tocksin/gtxl/resources/Assembly.xlsx

Sheet: Sheet1
 | Inst | Code |  | Mode | Code |  | Databus Source | Code |  | Zero Page Registers |  | Labels
 | ld | 0 |  | [80,D],AC | 0 |  | D | 0 |  | 0 | AC storage | VIDEO_HANDLER |  | 12
 | and | 32 |  | [80,X],AC | 4 |  | MEM | 1 |  | 1 | Y storage | BOOT_VECTOR |  | 46
 | or | 64 |  | [Y,D],AC | 8 |  | AC | 2 |  | 2 | X storage | MAIN_LOOP |  | 52
 | xor | 96 |  | [Y,X],AC | 12 |  | Y | 3 |  | 3 | BOOTCNT
 | add | 128 |  | [80,D],X | 16 |  |  | 0 |  | 4 | TEST COUNT
 | sub | 160 |  | [80,D],Y | 20
 | st | 192 |  | [80,D],VID | 24
 | bcc | 224 |  | [Y,X++],VID | 28
 | jmp | 224 |  |  | 0
 | bgt | 228 |  | AC | 0
 | blt | 232 |  | X | 16
 | bne | 236 |  | Y | 20
 | beq | 240 |  | VID | 24
 | bge | 244 |  | [80,D] | 0
 | ble | 248 |  | [80,X] | 4
 | bra | 252 |  | [Y,D] | 8
 | reti | 227 |  | [Y,X] | 12
 | nop | 2 |  | [Y,X++] | 28
ROM Address |  |  |  | Immediate Data |  | InstCode | ModeCode | DataBusCode | Full Instruction |  | Copy/Paste into VHDL
0 | st | [80,D] | AC | 0 |  | 192 | 0 | 2 | 194 |  |  | 0 | =>x" | C2 | ", | 1 | =>x" | 00 | ", -- | st | [80,D] | AC | -- store AC to 0x8000 | -- save register states
2 | st | [80,D] | Y | 1 |  | 192 | 0 | 3 | 195 |  |  | 2 | =>x" | C3 | ", | 3 | =>x" | 01 | ", -- | st | [80,D] | Y | -- store Y to 0x8001
4 | ld | X | D | 56 |  | 0 | 16 | 0 | 16 |  |  | 4 | =>x" | 10 | ", | 5 | =>x" | 38 | ", -- | ld | X | D | -- Set X to 0x55 | --reload timer
6 | ld | [80,D] | MEM | 3 |  | 0 | 0 | 1 | 1 |  |  | 6 | =>x" | 01 | ", | 7 | =>x" | 03 | ", -- | ld | [80,D] | MEM | -- Load BOOTCNT | --check if booting finished
8 | xor | AC | D | 55 |  | 96 | 0 | 0 | 96 |  |  | 8 | =>x" | 60 | ", | 9 | =>x" | 37 | ", -- | xor | AC | D | --XOR compare 55 with BOOTCNT
10 | bne |  | D | 46 |  | 236 | 0 | 0 | 236 |  |  | 10 | =>x" | EC | ", | 11 | =>x" | 2E | ", -- | bne | 0 | D | -- branch to BOOT_VECTOR if not equal
12 | ld | AC | D | 0 |  | 0 | 0 | 0 | 0 |  |  | 12 | =>x" | 00 | ", | 13 | =>x" | 00 | ", -- | ld | AC | D | -- clear registers | -- VIDEO_HANDLER
14 | ld | y | D | 0 |  | 0 | 20 | 0 | 20 |  |  | 14 | =>x" | 14 | ", | 15 | =>x" | 00 | ", -- | ld | y | D
16 | ld | [80,D],AC | MEM | 0 |  | 0 | 0 | 1 | 1 |  |  | 16 | =>x" | 01 | ", | 17 | =>x" | 00 | ", -- | ld | [80,D],AC | MEM | --load AC | --restore registers
18 | ld | [80,D],Y | MEM | 1 |  | 0 | 20 | 1 | 21 |  |  | 18 | =>x" | 15 | ", | 19 | =>x" | 01 | ", -- | ld | [80,D],Y | MEM | -- load Y
20 | reti |  |  |  |  | 227 | 0 | 0 | 227 |  |  | 20 | =>x" | E3 | ", | 21 | =>x" | 00 | ", -- | reti | 0 | 0 | -- return from interrupt
22 | nop |  |  |  |  | 2 | 0 | 0 | 2 |  |  | 22 | =>x" | 02 | ", | 23 | =>x" | 00 | ", -- | nop | 0 | 0
24 | nop |  |  |  |  | 2 | 0 | 0 | 2 |  |  | 24 | =>x" | 02 | ", | 25 | =>x" | 00 | ", -- | nop | 0 | 0
26 | nop |  |  |  |  | 2 | 0 | 0 | 2 |  |  | 26 | =>x" | 02 | ", | 27 | =>x" | 00 | ", -- | nop | 0 | 0
28 | nop |  |  |  |  | 2 | 0 | 0 | 2 |  |  | 28 | =>x" | 02 | ", | 29 | =>x" | 00 | ", -- | nop | 0 | 0
30 | nop |  |  |  |  | 2 | 0 | 0 | 2 |  |  | 30 | =>x" | 02 | ", | 31 | =>x" | 00 | ", -- | nop | 0 | 0
32 | nop |  |  |  |  | 2 | 0 | 0 | 2 |  |  | 32 | =>x" | 02 | ", | 33 | =>x" | 00 | ", -- | nop | 0 | 0
34 | nop |  |  |  |  | 2 | 0 | 0 | 2 |  |  | 34 | =>x" | 02 | ", | 35 | =>x" | 00 | ", -- | nop | 0 | 0
36 | nop |  |  |  |  | 2 | 0 | 0 | 2 |  |  | 36 | =>x" | 02 | ", | 37 | =>x" | 00 | ", -- | nop | 0 | 0
38 | nop |  |  |  |  | 2 | 0 | 0 | 2 |  |  | 38 | =>x" | 02 | ", | 39 | =>x" | 00 | ", -- | nop | 0 | 0
40 | nop |  |  |  |  | 2 | 0 | 0 | 2 |  |  | 40 | =>x" | 02 | ", | 41 | =>x" | 00 | ", -- | nop | 0 | 0
42 | nop |  |  |  |  | 2 | 0 | 0 | 2 |  |  | 42 | =>x" | 02 | ", | 43 | =>x" | 00 | ", -- | nop | 0 | 0
44 | nop |  |  |  |  | 2 | 0 | 0 | 2 |  |  | 44 | =>x" | 02 | ", | 45 | =>x" | 00 | ", -- | nop | 0 | 0
46 | ld | AC | D | 55 |  | 0 | 0 | 0 | 0 |  |  | 46 | =>x" | 00 | ", | 47 | =>x" | 37 | ", -- | ld | AC | D |  | -- BOOT_VECTOR
48 | st | [80,D] | AC | 3 |  | 192 | 0 | 2 | 194 |  |  | 48 | =>x" | C2 | ", | 49 | =>x" | 03 | ", -- | st | [80,D] | AC | -- store 55 to BOOTCNT
50 | ld | AC | D | 0 |  | 0 | 0 | 0 | 0 |  |  | 50 | =>x" | 00 | ", | 51 | =>x" | 00 | ", -- | ld | AC | D | --initialize AC with 0 | -- main test program:store value to memory, load it back, add to it, repeat
52 | st | [80,D] | AC | 4 |  | 192 | 0 | 2 | 194 |  |  | 52 | =>x" | C2 | ", | 53 | =>x" | 04 | ", -- | st | [80,D] | AC | --store value | -- MAIN_LOOP
54 | ld | [80,D] | MEM | 4 |  | 0 | 0 | 1 | 1 |  |  | 54 | =>x" | 01 | ", | 55 | =>x" | 04 | ", -- | ld | [80,D] | MEM | --load value
56 | add | AC | D | 1 |  | 128 | 0 | 0 | 128 |  |  | 56 | =>x" | 80 | ", | 57 | =>x" | 01 | ", -- | add | AC | D | --add 1
58 | ld | VID | AC |  |  | 0 | 24 | 2 | 26 |  |  | 58 | =>x" | 1A | ", | 59 | =>x" | 00 | ", -- | ld | VID | AC | -- copy result to VID output incrementing X for testing
60 | bra |  | D | 52 |  | 252 | 0 | 0 | 252 |  |  | 60 | =>x" | FC | ", | 61 | =>x" | 34 | ", -- | bra | 0 | D | -- branch back to MAIN_LOOP
62 |  |  |  |  |  | #N/A | 0 | 0 | #N/A |  |  | 62 | =>x" | #N/A | ", | 63 | =>x" | 00 | ", -- | 0 | 0 | 0
64 |  |  |  |  |  | #N/A | 0 | 0 | #N/A |  |  | 64 | =>x" | #N/A | ", | 65 | =>x" | 00 | ", -- | 0 | 0 | 0
66 |  |  |  |  |  | #N/A | 0 | 0 | #N/A |  |  | 66 | =>x" | #N/A | ", | 67 | =>x" | 00 | ", -- | 0 | 0 | 0
68 |  |  |  |  |  | #N/A | 0 | 0 | #N/A |  |  | 68 | =>x" | #N/A | ", | 69 | =>x" | 00 | ", -- | 0 | 0 | 0
70 |  |  |  |  |  | #N/A | 0 | 0 | #N/A |  |  | 70 | =>x" | #N/A | ", | 71 | =>x" | 00 | ", -- | 0 | 0 | 0
72 |  |  |  |  |  | #N/A | 0 | 0 | #N/A |  |  | 72 | =>x" | #N/A | ", | 73 | =>x" | 00 | ", -- | 0 | 0 | 0
74 |  |  |  |  |  | #N/A | 0 | 0 | #N/A |  |  | 74 | =>x" | #N/A | ", | 75 | =>x" | 00 | ", -- | 0 | 0 | 0
76 |  |  |  |  |  | #N/A | 0 | 0 | #N/A |  |  | 76 | =>x" | #N/A | ", | 77 | =>x" | 00 | ", -- | 0 | 0 | 0
78 |  |  |  |  |  | #N/A | 0 | 0 | #N/A |  |  | 78 | =>x" | #N/A | ", | 79 | =>x" | 00 | ", -- | 0 | 0 | 0
80 |  |  |  |  |  | #N/A | 0 | 0 | #N/A |  |  | 80 | =>x" | #N/A | ", | 81 | =>x" | 00 | ", -- | 0 | 0 | 0
82 |  |  |  |  |  | #N/A | 0 | 0 | #N/A |  |  | 82 | =>x" | #N/A | ", | 83 | =>x" | 00 | ", -- | 0 | 0 | 0
84 |  |  |  |  |  | #N/A | 0 | 0 | #N/A |  |  | 84 | =>x" | #N/A | ", | 85 | =>x" | 00 | ", -- | 0 | 0 | 0
86 |  |  |  |  |  | #N/A | 0 | 0 | #N/A |  |  | 86 | =>x" | #N/A | ", | 87 | =>x" | 00 | ", -- | 0 | 0 | 0
88 |  |  |  |  |  | #N/A | 0 | 0 | #N/A |  |  | 88 | =>x" | #N/A | ", | 89 | =>x" | 00 | ", -- | 0 | 0 | 0
90 |  |  |  |  |  | #N/A | 0 | 0 | #N/A |  |  | 90 | =>x" | #N/A | ", | 91 | =>x" | 00 | ", -- | 0 | 0 | 0
92 |  |  |  |  |  | #N/A | 0 | 0 | #N/A |  |  | 92 | =>x" | #N/A | ", | 93 | =>x" | 00 | ", -- | 0 | 0 | 0
94 |  |  |  |  |  | #N/A | 0 | 0 | #N/A |  |  | 94 | =>x" | #N/A | ", | 95 | =>x" | 00 | ", -- | 0 | 0 | 0
96 |  |  |  |  |  | #N/A | 0 | 0 | #N/A |  |  | 96 | =>x" | #N/A | ", | 97 | =>x" | 00 | ", -- | 0 | 0 | 0
98 |  |  |  |  |  | #N/A | 0 | 0 | #N/A |  |  | 98 | =>x" | #N/A | ", | 99 | =>x" | 00 | ", -- | 0 | 0 | 0
 | -- Save and restore register data
 | ld | [80,X],AC | D | 1 | -- initialize registers with unique values
 | ld | [80,X],X | D | 2
 | ld | [80,X],Y | D | 3
 | ld | [80,X],VID | D | 4
save | st | [80,00],AC | AC |  | -- store AC to 0x8000
 | ld | [Y,X],AC | Y
 | ld | [80,X],Y | D | 129
 | st | [Y,00],Y | AC |  | -- store Y to 0x8100
 | ld | [80,X],Y | D | 63
 | ld | [Y,X],AC | MEM |  | -- load from ROM table at 0x3F00-3FFF
 | ld | [80,X],X | D | 5
 | st | [80,X],AC | AC |  | -- store X to 0x8005
do work | ld | [80,X],AC | D | 0 | -- clear registers
 | ld | [80,X],X | D | 0
 | ld | [80,X],Y | D | 0 | -- restore registers from memory
 | ld | [80,X],Y | D | 129 | -- load Y from 0x8100
 | ld | [Y,00],Y | MEM
 | ld | [80,X],X | D | 5 | -- load X from 0x8005
 | ld | [80,X],X | MEM
 | ld | [80,00],AC | MEM |  | -- load AC from 0x8000
 | reti

Sheet: Sheet2
 |  | 16128
0 | 3F00 | 16128 | =>x" | 00 | ", -- | 3F00
1 | 3F01 | 16129 | =>x" | 01 | ", -- | 3F01
2 | 3F02 | 16130 | =>x" | 02 | ", -- | 3F02
3 | 3F03 | 16131 | =>x" | 03 | ", -- | 3F03
4 | 3F04 | 16132 | =>x" | 04 | ", -- | 3F04
5 | 3F05 | 16133 | =>x" | 05 | ", -- | 3F05
6 | 3F06 | 16134 | =>x" | 06 | ", -- | 3F06
7 | 3F07 | 16135 | =>x" | 07 | ", -- | 3F07
8 | 3F08 | 16136 | =>x" | 08 | ", -- | 3F08
9 | 3F09 | 16137 | =>x" | 09 | ", -- | 3F09
10 | 3F0A | 16138 | =>x" | 0A | ", -- | 3F0A
11 | 3F0B | 16139 | =>x" | 0B | ", -- | 3F0B
12 | 3F0C | 16140 | =>x" | 0C | ", -- | 3F0C
13 | 3F0D | 16141 | =>x" | 0D | ", -- | 3F0D
14 | 3F0E | 16142 | =>x" | 0E | ", -- | 3F0E
15 | 3F0F | 16143 | =>x" | 0F | ", -- | 3F0F
16 | 3F10 | 16144 | =>x" | 10 | ", -- | 3F10
17 | 3F11 | 16145 | =>x" | 11 | ", -- | 3F11
18 | 3F12 | 16146 | =>x" | 12 | ", -- | 3F12
19 | 3F13 | 16147 | =>x" | 13 | ", -- | 3F13
20 | 3F14 | 16148 | =>x" | 14 | ", -- | 3F14
21 | 3F15 | 16149 | =>x" | 15 | ", -- | 3F15
22 | 3F16 | 16150 | =>x" | 16 | ", -- | 3F16
23 | 3F17 | 16151 | =>x" | 17 | ", -- | 3F17
24 | 3F18 | 16152 | =>x" | 18 | ", -- | 3F18
25 | 3F19 | 16153 | =>x" | 19 | ", -- | 3F19
26 | 3F1A | 16154 | =>x" | 1A | ", -- | 3F1A
27 | 3F1B | 16155 | =>x" | 1B | ", -- | 3F1B
28 | 3F1C | 16156 | =>x" | 1C | ", -- | 3F1C
29 | 3F1D | 16157 | =>x" | 1D | ", -- | 3F1D
30 | 3F1E | 16158 | =>x" | 1E | ", -- | 3F1E
31 | 3F1F | 16159 | =>x" | 1F | ", -- | 3F1F
32 | 3F20 | 16160 | =>x" | 20 | ", -- | 3F20
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
250 | 3FFA | 16378 | =>x" | FA | ", -- | 3FFA
251 | 3FFB | 16379 | =>x" | FB | ", -- | 3FFB
252 | 3FFC | 16380 | =>x" | FC | ", -- | 3FFC
253 | 3FFD | 16381 | =>x" | FD | ", -- | 3FFD
254 | 3FFE | 16382 | =>x" | FE | ", -- | 3FFE
255 | 3FFF | 16383 | =>x" | FF | ", -- | 3FFF

Sheet: fibon
 | Inst | Code |  | Mode | Code |  | Databus Source | Code
 | ld | 0 |  | [80,X],AC | 0 |  | D | 0
 | and | 32 |  | [Y,X],AC | 4 |  | AC | 1
 | or | 64 |  | [80,00],AC | 8 |  | MEM | 2
 | xor | 96 |  | [80,X],X | 12 |  | Y | 3
 | add | 128 |  | [80,X],Y | 16 |  |  | 0
 | sub | 160 |  | [Y,00],Y | 20
 | st | 192 |  | [80,X],VID | 24
 | bcc | 224 |  | [Y,X++],VID | 28
 | jmp | 224 |  |  | 0
 | bgt | 228
 | blt | 232
 | bne | 236
 | beq | 240
 | bge | 244
 | ble | 248
 | bra | 252
 | reti | 227
ROM Address |  |  |  | Immediate Data |  | InstCode | ModeCode | DataBusCode | Full Instruction | Copy/Paste into VHDL
0 | ld | [80,X],Y | D | 64 |  | 0 | 16 | 0 | 16 |  | 0 | =>x" | 10 | ", | 1 | =>x" | 40 | ", -- | ld | [80,X],Y | D | -- Set Y to 0x4000
2 | st | [Y,X],AC | D | 56 |  | 192 | 4 | 0 | 196 |  | 2 | =>x" | C4 | ", | 3 | =>x" | 38 | ", -- | st | [Y,X],AC | D | -- Load timer with 200
4 | ld | [80,X],X | D | 1 |  | 0 | 12 | 0 | 12 |  | 4 | =>x" | 0C | ", | 5 | =>x" | 01 | ", -- | ld | [80,X],X | D | --Load X with 1
6 | ld | [80,X],AC | D | 1 |  | 0 | 0 | 0 | 0 |  | 6 | =>x" | 00 | ", | 7 | =>x" | 01 | ", -- | ld | [80,X],AC | D | --Load AC with 1
8 | xor | [80,X],AC | MEM |  |  | 96 | 0 | 2 | 98 |  | 8 | =>x" | 62 | ", | 9 | =>x" | 00 | ", -- | xor | [80,X],AC | MEM | --XOR compare AC with [80,X]
10 | beq |  | D | 16 |  | 240 | 0 | 0 | 240 |  | 10 | =>x" | F0 | ", | 11 | =>x" | 10 | ", -- | beq | 0 | D | --branch if equal
12 | st | [80,X],AC | AC |  |  | 192 | 0 | 1 | 193 |  | 12 | =>x" | C1 | ", | 13 | =>x" | 00 | ", -- | st | [80,X],AC | AC | --st [80,X] with 1 -- cold boot detection
14 | reti |  |  |  |  | 227 | 0 | 0 | 227 |  | 14 | =>x" | E3 | ", | 15 | =>x" | 00 | ", -- | reti | 0 | 0 | --reti (jump to 0x0000) to enable interrupts
16 | st | [80,00],AC | AC |  |  | 192 | 8 | 1 | 201 |  | 16 | =>x" | C9 | ", | 17 | =>x" | 00 | ", -- | st | [80,00],AC | AC | -- store AC to 0x8000
18 | ld | [Y,X],AC | Y |  |  | 0 | 4 | 3 | 7 |  | 18 | =>x" | 07 | ", | 19 | =>x" | 00 | ", -- | ld | [Y,X],AC | Y
20 | ld | [80,X],Y | D | 129 |  | 0 | 16 | 0 | 16 |  | 20 | =>x" | 10 | ", | 21 | =>x" | 81 | ", -- | ld | [80,X],Y | D
22 | st | [Y,00],Y | AC |  |  | 192 | 20 | 1 | 213 |  | 22 | =>x" | D5 | ", | 23 | =>x" | 00 | ", -- | st | [Y,00],Y | AC | -- store Y to 0x8100
24 | ld | [80,X],Y | D | 63 |  | 0 | 16 | 0 | 16 |  | 24 | =>x" | 10 | ", | 25 | =>x" | 3F | ", -- | ld | [80,X],Y | D
26 | ld | [Y,X],AC | MEM |  |  | 0 | 4 | 2 | 6 |  | 26 | =>x" | 06 | ", | 27 | =>x" | 00 | ", -- | ld | [Y,X],AC | MEM | -- load from ROM table at 0x3F00-3FFF
28 | ld | [80,X],X | D | 5 |  | 0 | 12 | 0 | 12 |  | 28 | =>x" | 0C | ", | 29 | =>x" | 05 | ", -- | ld | [80,X],X | D
30 | st | [80,X],AC | AC |  |  | 192 | 0 | 1 | 193 |  | 30 | =>x" | C1 | ", | 31 | =>x" | 00 | ", -- | st | [80,X],AC | AC | -- store X to 0x8005
32 | ld | [80,X],AC | D | 0 |  | 0 | 0 | 0 | 0 |  | 32 | =>x" | 00 | ", | 33 | =>x" | 00 | ", -- | ld | [80,X],AC | D | -- clear registers
34 | ld | [80,X],X | D | 0 |  | 0 | 12 | 0 | 12 |  | 34 | =>x" | 0C | ", | 35 | =>x" | 00 | ", -- | ld | [80,X],X | D
36 | ld | [80,X],Y | D | 0 |  | 0 | 16 | 0 | 16 |  | 36 | =>x" | 10 | ", | 37 | =>x" | 00 | ", -- | ld | [80,X],Y | D | -- restore registers from memory
38 | ld | [80,X],Y | D | 129 |  | 0 | 16 | 0 | 16 |  | 38 | =>x" | 10 | ", | 39 | =>x" | 81 | ", -- | ld | [80,X],Y | D | -- load Y from 0x8100
40 | ld | [Y,00],Y | MEM |  |  | 0 | 20 | 2 | 22 |  | 40 | =>x" | 16 | ", | 41 | =>x" | 00 | ", -- | ld | [Y,00],Y | MEM
42 | ld | [80,X],X | D | 5 |  | 0 | 12 | 0 | 12 |  | 42 | =>x" | 0C | ", | 43 | =>x" | 05 | ", -- | ld | [80,X],X | D | -- load X from 0x8005
44 | ld | [80,X],X | MEM |  |  | 0 | 12 | 2 | 14 |  | 44 | =>x" | 0E | ", | 45 | =>x" | 00 | ", -- | ld | [80,X],X | MEM
46 | ld | [80,00],AC | MEM |  |  | 0 | 8 | 2 | 10 |  | 46 | =>x" | 0A | ", | 47 | =>x" | 00 | ", -- | ld | [80,00],AC | MEM | -- load AC from 0x8000
48 | reti |  |  |  |  | 227 | 0 | 0 | 227 |  | 48 | =>x" | E3 | ", | 49 | =>x" | 00 | ", -- | reti | 0 | 0
50 | ld | [80,X],X | D | 10 |  | 0 | 12 | 0 | 12 |  | 50 | =>x" | 0C | ", | 51 | =>x" | 0A | ", -- | ld | [80,X],X | D | --start of fibbonachi test
52 | ld | [80,X],AC | D | 0 |  | 0 | 0 | 0 | 0 |  | 52 | =>x" | 00 | ", | 53 | =>x" | 00 | ", -- | ld | [80,X],AC | D | --set n-1 to 0
54 | st | [80,X],AC | AC |  |  | 192 | 0 | 1 | 193 |  | 54 | =>x" | C1 | ", | 55 | =>x" | 00 | ", -- | st | [80,X],AC | AC
56 | ld | [80,X],X | D | 11 |  | 0 | 12 | 0 | 12 |  | 56 | =>x" | 0C | ", | 57 | =>x" | 0B | ", -- | ld | [80,X],X | D | --set n to 1
58 | ld | [80,X],AC | D | 1 |  | 0 | 0 | 0 | 0 |  | 58 | =>x" | 00 | ", | 59 | =>x" | 01 | ", -- | ld | [80,X],AC | D
60 | st | [80,X],AC | AC |  |  | 192 | 0 | 1 | 193 |  | 60 | =>x" | C1 | ", | 61 | =>x" | 00 | ", -- | st | [80,X],AC | AC
62 | ld | [80,X],X | D | 10 |  | 0 | 12 | 0 | 12 |  | 62 | =>x" | 0C | ", | 63 | =>x" | 0A | ", -- | ld | [80,X],X | D | --start loop
64 | ld | [80,X],AC | MEM |  |  | 0 | 0 | 2 | 2 |  | 64 | =>x" | 02 | ", | 65 | =>x" | 00 | ", -- | ld | [80,X],AC | MEM | -- load n-1
66 | ld | [80,X],X | D | 11 |  | 0 | 12 | 0 | 12 |  | 66 | =>x" | 0C | ", | 67 | =>x" | 0B | ", -- | ld | [80,X],X | D
68 | add | [80,X],AC | MEM |  |  | 128 | 0 | 2 | 130 |  | 68 | =>x" | 82 | ", | 69 | =>x" | 00 | ", -- | add | [80,X],AC | MEM | --add n
70 | ld | [80,X],X | D | 12 |  | 0 | 12 | 0 | 12 |  | 70 | =>x" | 0C | ", | 71 | =>x" | 0C | ", -- | ld | [80,X],X | D
72 | st | [80,X],AC | AC |  |  | 192 | 0 | 1 | 193 |  | 72 | =>x" | C1 | ", | 73 | =>x" | 00 | ", -- | st | [80,X],AC | AC | -- store n+1
74 | ld | [80,X],X | D | 11 |  | 0 | 12 | 0 | 12 |  | 74 | =>x" | 0C | ", | 75 | =>x" | 0B | ", -- | ld | [80,X],X | D
76 | ld | [80,X],AC | MEM |  |  | 0 | 0 | 2 | 2 |  | 76 | =>x" | 02 | ", | 77 | =>x" | 00 | ", -- | ld | [80,X],AC | MEM | ---load n
78 | ld | [80,X],X | D | 10 |  | 0 | 12 | 0 | 12 |  | 78 | =>x" | 0C | ", | 79 | =>x" | 0A | ", -- | ld | [80,X],X | D
80 | st | [80,X],AC | AC |  |  | 192 | 0 | 1 | 193 |  | 80 | =>x" | C1 | ", | 81 | =>x" | 00 | ", -- | st | [80,X],AC | AC | --move n to n-1
82 | ld | [80,X],X | D | 12 |  | 0 | 12 | 0 | 12 |  | 82 | =>x" | 0C | ", | 83 | =>x" | 0C | ", -- | ld | [80,X],X | D
84 | ld | [80,X],AC | MEM |  |  | 0 | 0 | 2 | 2 |  | 84 | =>x" | 02 | ", | 85 | =>x" | 00 | ", -- | ld | [80,X],AC | MEM | --load n+1
86 | ld | [80,X],X | D | 11 |  | 0 | 12 | 0 | 12 |  | 86 | =>x" | 0C | ", | 87 | =>x" | 0B | ", -- | ld | [80,X],X | D
88 | st | [80,X],AC | MEM |  |  | 192 | 0 | 2 | 194 |  | 88 | =>x" | C2 | ", | 89 | =>x" | 00 | ", -- | st | [80,X],AC | MEM | --move n+1 to n
90 | ld | [80,X],VID | MEM |  |  | 0 | 24 | 2 | 26 |  | 90 | =>x" | 1A | ", | 91 | =>x" | 00 | ", -- | ld | [80,X],VID | MEM | --move n+1 to vid for output
92 | bra |  | D | 62 |  | 252 | 0 | 0 | 252 |  | 92 | =>x" | FC | ", | 93 | =>x" | 3E | ", -- | bra | 0 | D
94 |  |  |  |  |  | #N/A | 0 | 0 | #N/A |  | 94 | =>x" | #N/A | ", | 95 | =>x" | 00 | ", -- | 0 | 0 | 0
96 |  |  |  |  |  | #N/A | 0 | 0 | #N/A |  | 96 | =>x" | #N/A | ", | 97 | =>x" | 00 | ", -- | 0 | 0 | 0
98 |  |  |  |  |  | #N/A | 0 | 0 | #N/A |  | 98 | =>x" | #N/A | ", | 99 | =>x" | 00 | ", -- | 0 | 0 | 0
 | -- Save and restore register data
 | ld | [80,X],AC | D | 1 | -- initialize registers with unique values
 | ld | [80,X],X | D | 2
 | ld | [80,X],Y | D | 3
 | ld | [80,X],VID | D | 4
save | st | [80,00],AC | AC |  | -- store AC to 0x8000
 | ld | [Y,X],AC | Y
 | ld | [80,X],Y | D | 129
 | st | [Y,00],Y | AC |  | -- store Y to 0x8100
 | ld | [80,X],Y | D | 63
 | ld | [Y,X],AC | MEM |  | -- load from ROM table at 0x3F00-3FFF
 | ld | [80,X],X | D | 5
 | st | [80,X],AC | AC |  | -- store X to 0x8005
do work | ld | [80,X],AC | D | 0 | -- clear registers
 | ld | [80,X],X | D | 0
 | ld | [80,X],Y | D | 0 | -- restore registers from memory
 | ld | [80,X],Y | D | 129 | -- load Y from 0x8100
 | ld | [Y,00],Y | MEM
 | ld | [80,X],X | D | 5 | -- load X from 0x8005
 | ld | [80,X],X | MEM
 | ld | [80,00],AC | MEM |  | -- load AC from 0x8000
 | reti

Sheet: Sheet3
*
DEPTH | = | 624
WIDTH | = | 8
ADDRESS_RADIX | = | HEX
DATA_RADIX | = | HEX
CONTENT
BEGIN |  |  | Copy/Paste into VHDL
 | 0 | C2 |  | 0 | =>x" | C2 | ",
 | 1 | 00 |  | 1 | =>x" | 00 | ",
 | 2 | 0B |  | 2 | =>x" | 0B | ",
 | 3 | 00 |  | 3 | =>x" | 00 | ",
 | 4 | C2 |  | 4 | =>x" | C2 | ",
 | 5 | 01 |  | 5 | =>x" | 01 | ",
 | 6 | 01 |  | 6 | =>x" | 01 | ",
 | 7 | 03 |  | 7 | =>x" | 03 | ",
 | 8 | 60 |  | 8 | =>x" | 60 | ",
 | 9 | 37 |  | 9 | =>x" | 37 | ",
 | A | EC |  | 10 | =>x" | EC | ",
 | B | BE |  | 11 | =>x" | BE | ",
 | C | FD |  | 12 | =>x" | FD | ",
 | D | 06 |  | 13 | =>x" | 06 | ",
 | E | 10 |  | 14 | =>x" | 10 | ",
 | F | A2 |  | 15 | =>x" | A2 | ",
 | 10 | 18 |  | 16 | =>x" | 18 | ",
 | 11 | 00 |  | 17 | =>x" | 00 | ",
 | 12 | 01 |  | 18 | =>x" | 01 | ",
 | 13 | 08 |  | 19 | =>x" | 08 | ",
 | 14 | 60 |  | 20 | =>x" | 60 | ",
 | 15 | 18 |  | 21 | =>x" | 18 | ",
 | 16 | F0 |  | 22 | =>x" | F0 | ",
 | 17 | 1A |  | 23 | =>x" | 1A | ",
 | 18 | 01 |  | 24 | =>x" | 01 | ",
 | 19 | 08 |  | 25 | =>x" | 08 | ",
 | 1A | 80 |  | 26 | =>x" | 80 | ",
 | 1B | 01 |  | 27 | =>x" | 01 | ",
 | 1C | 02 |  | 28 | =>x" | 02 | ",
 | 1D | 00 |  | 29 | =>x" | 00 | ",
 | 1E | 18 |  | 30 | =>x" | 18 | ",
 | 1F | 40 |  | 31 | =>x" | 40 | ",
 | 20 | C2 |  | 32 | =>x" | C2 | ",
 | 21 | 08 |  | 33 | =>x" | 08 | ",
 | 22 | 60 |  | 34 | =>x" | 60 | ",
 | 23 | 0C |  | 35 | =>x" | 0C | ",
 | 24 | F0 |  | 36 | =>x" | F0 | ",
 | 25 | 36 |  | 37 | =>x" | 36 | ",
 | 26 | 01 |  | 38 | =>x" | 01 | ",
 | 27 | 08 |  | 39 | =>x" | 08 | ",
 | 28 | 60 |  | 40 | =>x" | 60 | ",
 | 29 | 06 |  | 41 | =>x" | 06 | ",
 | 2A | F0 |  | 42 | =>x" | F0 | ",
 | 2B | 40 |  | 43 | =>x" | 40 | ",
 | 2C | 00 |  | 44 | =>x" | 00 | ",
 | 2D | 0E |  | 45 | =>x" | 0E | ",
 | 2E | C2 |  | 46 | =>x" | C2 | ",
 | 2F | 06 |  | 47 | =>x" | 06 | ",
 | 30 | 01 |  | 48 | =>x" | 01 | ",
 | 31 | 00 |  | 49 | =>x" | 00 | ",
 | 32 | 15 |  | 50 | =>x" | 15 | ",
 | 33 | 01 |  | 51 | =>x" | 01 | ",
 | 34 | E3 |  | 52 | =>x" | E3 | ",
 | 35 | 00 |  | 53 | =>x" | 00 | ",
 | 36 | 00 |  | 54 | =>x" | 00 | ",
 | 37 | 8A |  | 55 | =>x" | 8A | ",
 | 38 | C2 |  | 56 | =>x" | C2 | ",
 | 39 | 06 |  | 57 | =>x" | 06 | ",
 | 3A | 01 |  | 58 | =>x" | 01 | ",
 | 3B | 00 |  | 59 | =>x" | 00 | ",
 | 3C | 15 |  | 60 | =>x" | 15 | ",
 | 3D | 01 |  | 61 | =>x" | 01 | ",
 | 3E | E3 |  | 62 | =>x" | E3 | ",
 | 3F | 00 |  | 63 | =>x" | 00 | ",
 | 40 | C2 |  | 64 | =>x" | C2 | ",
 | 41 | 09 |  | 65 | =>x" | 09 | ",
 | 42 | 00 |  | 66 | =>x" | 00 | ",
 | 43 | 4C |  | 67 | =>x" | 4C | ",
 | 44 | C2 |  | 68 | =>x" | C2 | ",
 | 45 | 06 |  | 69 | =>x" | 06 | ",
 | 46 | 01 |  | 70 | =>x" | 01 | ",
 | 47 | 00 |  | 71 | =>x" | 00 | ",
 | 48 | 15 |  | 72 | =>x" | 15 | ",
 | 49 | 01 |  | 73 | =>x" | 01 | ",
 | 4A | E3 |  | 74 | =>x" | E3 | ",
 | 4B | 00 |  | 75 | =>x" | 00 | ",
 | 4C | 10 |  | 76 | =>x" | 10 | ",
 | 4D | A2 |  | 77 | =>x" | A2 | ",
 | 4E | 18 |  | 78 | =>x" | 18 | ",
 | 4F | 00 |  | 79 | =>x" | 00 | ",
 | 50 | 00 |  | 80 | =>x" | 00 | ",
 | 51 | 5A |  | 81 | =>x" | 5A | ",
 | 52 | C2 |  | 82 | =>x" | C2 | ",
 | 53 | 06 |  | 83 | =>x" | 06 | ",
 | 54 | 01 |  | 84 | =>x" | 01 | ",
 | 55 | 00 |  | 85 | =>x" | 00 | ",
 | 56 | 15 |  | 86 | =>x" | 15 | ",
 | 57 | 01 |  | 87 | =>x" | 01 | ",
 | 58 | E3 |  | 88 | =>x" | E3 | ",
 | 59 | 00 |  | 89 | =>x" | 00 | ",
 | 5A | 10 |  | 90 | =>x" | 10 | ",
 | 5B | A2 |  | 91 | =>x" | A2 | ",
 | 5C | 18 |  | 92 | =>x" | 18 | ",
 | 5D | 40 |  | 93 | =>x" | 40 | ",
 | 5E | 01 |  | 94 | =>x" | 01 | ",
 | 5F | 09 |  | 95 | =>x" | 09 | ",
 | 60 | 80 |  | 96 | =>x" | 80 | ",
 | 61 | 01 |  | 97 | =>x" | 01 | ",
 | 62 | C2 |  | 98 | =>x" | C2 | ",
 | 63 | 09 |  | 99 | =>x" | 09 | ",
 | 64 | 60 |  | 100 | =>x" | 60 | ",
 | 65 | 06 |  | 101 | =>x" | 06 | ",
 | 66 | 02 |  | 102 | =>x" | 02 | ",
 | 67 | 00 |  | 103 | =>x" | 00 | ",
 | 68 | 02 |  | 104 | =>x" | 02 | ",
 | 69 | 00 |  | 105 | =>x" | 00 | ",
 | 6A | 02 |  | 106 | =>x" | 02 | ",
 | 6B | 00 |  | 107 | =>x" | 00 | ",
 | 6C | 02 |  | 108 | =>x" | 02 | ",
 | 6D | 00 |  | 109 | =>x" | 00 | ",
 | 6E | 02 |  | 110 | =>x" | 02 | ",
 | 6F | 00 |  | 111 | =>x" | 00 | ",
 | 70 | 02 |  | 112 | =>x" | 02 | ",
 | 71 | 00 |  | 113 | =>x" | 00 | ",
 | 72 | 02 |  | 114 | =>x" | 02 | ",
 | 73 | 00 |  | 115 | =>x" | 00 | ",
 | 74 | 02 |  | 116 | =>x" | 02 | ",
 | 75 | 00 |  | 117 | =>x" | 00 | ",
 | 76 | 02 |  | 118 | =>x" | 02 | ",
 | 77 | 00 |  | 119 | =>x" | 00 | ",
 | 78 | 02 |  | 120 | =>x" | 02 | ",
 | 79 | 00 |  | 121 | =>x" | 00 | ",
 | 7A | 18 |  | 122 | =>x" | 18 | ",
 | 7B | 00 |  | 123 | =>x" | 00 | ",
 | 7C | F0 |  | 124 | =>x" | F0 | ",
 | 7D | 84 |  | 125 | =>x" | 84 | ",
 | 7E | 01 |  | 126 | =>x" | 01 | ",
 | 7F | 00 |  | 127 | =>x" | 00 | ",
 | 80 | 15 |  | 128 | =>x" | 15 | ",
 | 81 | 01 |  | 129 | =>x" | 01 | ",
 | 82 | E3 |  | 130 | =>x" | E3 | ",
 | 83 | 00 |  | 131 | =>x" | 00 | ",
 | 84 | 00 |  | 132 | =>x" | 00 | ",
 | 85 | 0E |  | 133 | =>x" | 0E | ",
 | 86 | C2 |  | 134 | =>x" | C2 | ",
 | 87 | 06 |  | 135 | =>x" | 06 | ",
 | 88 | FC |  | 136 | =>x" | FC | ",
 | 89 | 0E |  | 137 | =>x" | 0E | ",
 | 8A | 10 |  | 138 | =>x" | 10 | ",
 | 8B | 3C |  | 139 | =>x" | 3C | ",
 | 8C | 18 |  | 140 | =>x" | 18 | ",
 | 8D | 00 |  | 141 | =>x" | 00 | ",
 | 8E | 00 |  | 142 | =>x" | 00 | ",
 | 8F | 8A |  | 143 | =>x" | 8A | ",
 | 90 | C2 |  | 144 | =>x" | C2 | ",
 | 91 | 06 |  | 145 | =>x" | 06 | ",
 | 92 | 01 |  | 146 | =>x" | 01 | ",
 | 93 | 08 |  | 147 | =>x" | 08 | ",
 | 94 | 80 |  | 148 | =>x" | 80 | ",
 | 95 | 01 |  | 149 | =>x" | 01 | ",
 | 96 | C2 |  | 150 | =>x" | C2 | ",
 | 97 | 08 |  | 151 | =>x" | 08 | ",
 | 98 | 60 |  | 152 | =>x" | 60 | ",
 | 99 | 18 |  | 153 | =>x" | 18 | ",
 | 9A | 02 |  | 154 | =>x" | 02 | ",
 | 9B | 00 |  | 155 | =>x" | 00 | ",
 | 9C | 02 |  | 156 | =>x" | 02 | ",
 | 9D | 00 |  | 157 | =>x" | 00 | ",
 | 9E | 02 |  | 158 | =>x" | 02 | ",
 | 9F | 00 |  | 159 | =>x" | 00 | ",
 | A0 | 02 |  | 160 | =>x" | 02 | ",
 | A1 | 00 |  | 161 | =>x" | 00 | ",
 | A2 | 02 |  | 162 | =>x" | 02 | ",
 | A3 | 00 |  | 163 | =>x" | 00 | ",
 | A4 | 02 |  | 164 | =>x" | 02 | ",
 | A5 | 00 |  | 165 | =>x" | 00 | ",
 | A6 | 02 |  | 166 | =>x" | 02 | ",
 | A7 | 00 |  | 167 | =>x" | 00 | ",
 | A8 | 02 |  | 168 | =>x" | 02 | ",
 | A9 | 00 |  | 169 | =>x" | 00 | ",
 | AA | 18 |  | 170 | =>x" | 18 | ",
 | AB | 40 |  | 171 | =>x" | 40 | ",
 | AC | EC |  | 172 | =>x" | EC | ",
 | AD | B8 |  | 173 | =>x" | B8 | ",
 | AE | 00 |  | 174 | =>x" | 00 | ",
 | AF | 81 |  | 175 | =>x" | 81 | ",
 | B0 | C2 |  | 176 | =>x" | C2 | ",
 | B1 | 05 |  | 177 | =>x" | 05 | ",
 | B2 | 00 |  | 178 | =>x" | 00 | ",
 | B3 | E2 |  | 179 | =>x" | E2 | ",
 | B4 | C2 |  | 180 | =>x" | C2 | ",
 | B5 | 06 |  | 181 | =>x" | 06 | ",
 | B6 | 10 |  | 182 | =>x" | 10 | ",
 | B7 | F1 |  | 183 | =>x" | F1 | ",
 | B8 | 01 |  | 184 | =>x" | 01 | ",
 | B9 | 00 |  | 185 | =>x" | 00 | ",
 | BA | 15 |  | 186 | =>x" | 15 | ",
 | BB | 01 |  | 187 | =>x" | 01 | ",
 | BC | E3 |  | 188 | =>x" | E3 | ",
 | BD | 00 |  | 189 | =>x" | 00 | ",
 | BE | 00 |  | 190 | =>x" | 00 | ",
 | BF | 37 |  | 191 | =>x" | 37 | ",
 | C0 | C2 |  | 192 | =>x" | C2 | ",
 | C1 | 03 |  | 193 | =>x" | 03 | ",
 | C2 | 00 |  | 194 | =>x" | 00 | ",
 | C3 | E2 |  | 195 | =>x" | E2 | ",
 | C4 | C2 |  | 196 | =>x" | C2 | ",
 | C5 | 06 |  | 197 | =>x" | 06 | ",
 | C6 | 00 |  | 198 | =>x" | 00 | ",
 | C7 | 52 |  | 199 | =>x" | 52 | ",
 | C8 | C2 |  | 200 | =>x" | C2 | ",
 | C9 | 07 |  | 201 | =>x" | 07 | ",
 | CA | 00 |  | 202 | =>x" | 00 | ",
 | CB | 81 |  | 203 | =>x" | 81 | ",
 | CC | C2 |  | 204 | =>x" | C2 | ",
 | CD | 05 |  | 205 | =>x" | 05 | ",
 | CE | 62 |  | 206 | =>x" | 62 | ",
 | CF | 00 |  | 207 | =>x" | 00 | ",
 | D0 | C2 |  | 208 | =>x" | C2 | ",
 | D1 | 08 |  | 209 | =>x" | 08 | ",
 | D2 | C2 |  | 210 | =>x" | C2 | ",
 | D3 | 09 |  | 211 | =>x" | 09 | ",
 | D4 | 00 |  | 212 | =>x" | 00 | ",
 | D5 | 00 |  | 213 | =>x" | 00 | ",
 | D6 | 14 |  | 214 | =>x" | 14 | ",
 | D7 | 40 |  | 215 | =>x" | 40 | ",
 | D8 | C2 |  | 216 | =>x" | C2 | ",
 | D9 | 04 |  | 217 | =>x" | 04 | ",
 | DA | 01 |  | 218 | =>x" | 01 | ",
 | DB | 04 |  | 219 | =>x" | 04 | ",
 | DC | 80 |  | 220 | =>x" | 80 | ",
 | DD | 01 |  | 221 | =>x" | 01 | ",
 | DE | CA |  | 222 | =>x" | CA | ",
 | DF | 00 |  | 223 | =>x" | 00 | ",
 | E0 | FC |  | 224 | =>x" | FC | ",
 | E1 | D8 |  | 225 | =>x" | D8 | ",
 | E2 | 15 |  | 226 | =>x" | 15 | ",
 | E3 | 05 |  | 227 | =>x" | 05 | ",
 | E4 | 00 |  | 228 | =>x" | 00 | ",
 | E5 | C0 |  | 229 | =>x" | C0 | ",
 | E6 | 5D |  | 230 | =>x" | 5D | ",
 | E7 | 00 |  | 231 | =>x" | 00 | ",
 | E8 | 5D |  | 232 | =>x" | 5D | ",
 | E9 | 00 |  | 233 | =>x" | 00 | ",
 | EA | 5D |  | 234 | =>x" | 5D | ",
 | EB | 00 |  | 235 | =>x" | 00 | ",
 | EC | 5D |  | 236 | =>x" | 5D | ",
 | ED | 00 |  | 237 | =>x" | 00 | ",
 | EE | 5D |  | 238 | =>x" | 5D | ",
 | EF | 00 |  | 239 | =>x" | 00 | ",
 | F0 | 5D |  | 240 | =>x" | 5D | ",
 | F1 | 00 |  | 241 | =>x" | 00 | ",
 | F2 | 5D |  | 242 | =>x" | 5D | ",
 | F3 | 00 |  | 243 | =>x" | 00 | ",
 | F4 | 5D |  | 244 | =>x" | 5D | ",
 | F5 | 00 |  | 245 | =>x" | 00 | ",
 | F6 | 5D |  | 246 | =>x" | 5D | ",
 | F7 | 00 |  | 247 | =>x" | 00 | ",
 | F8 | 5D |  | 248 | =>x" | 5D | ",
 | F9 | 00 |  | 249 | =>x" | 00 | ",
 | FA | 5D |  | 250 | =>x" | 5D | ",
 | FB | 00 |  | 251 | =>x" | 00 | ",
 | FC | 5D |  | 252 | =>x" | 5D | ",
 | FD | 00 |  | 253 | =>x" | 00 | ",
 | FE | 5D |  | 254 | =>x" | 5D | ",
 | FF | 00 |  | 255 | =>x" | 00 | ",
 | 100 | 5D |  | 256 | =>x" | 5D | ",
 | 101 | 00 |  | 257 | =>x" | 00 | ",
 | 102 | 5D |  | 258 | =>x" | 5D | ",
 | 103 | 00 |  | 259 | =>x" | 00 | ",
 | 104 | 5D |  | 260 | =>x" | 5D | ",
 | 105 | 00 |  | 261 | =>x" | 00 | ",
 | 106 | 5D |  | 262 | =>x" | 5D | ",
 | 107 | 00 |  | 263 | =>x" | 00 | ",
 | 108 | 5D |  | 264 | =>x" | 5D | ",
 | 109 | 00 |  | 265 | =>x" | 00 | ",
 | 10A | 5D |  | 266 | =>x" | 5D | ",
 | 10B | 00 |  | 267 | =>x" | 00 | ",
 | 10C | 5D |  | 268 | =>x" | 5D | ",
 | 10D | 00 |  | 269 | =>x" | 00 | ",
 | 10E | 5D |  | 270 | =>x" | 5D | ",
 | 10F | 00 |  | 271 | =>x" | 00 | ",
 | 110 | 5D |  | 272 | =>x" | 5D | ",
 | 111 | 00 |  | 273 | =>x" | 00 | ",
 | 112 | 5D |  | 274 | =>x" | 5D | ",
 | 113 | 00 |  | 275 | =>x" | 00 | ",
 | 114 | 5D |  | 276 | =>x" | 5D | ",
 | 115 | 00 |  | 277 | =>x" | 00 | ",
 | 116 | 5D |  | 278 | =>x" | 5D | ",
 | 117 | 00 |  | 279 | =>x" | 00 | ",
 | 118 | 5D |  | 280 | =>x" | 5D | ",
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
 | 188 | 5D |  | 392 | =>x" | 5D | ",
 | 189 | 00 |  | 393 | =>x" | 00 | ",
 | 18A | 5D |  | 394 | =>x" | 5D | ",
 | 18B | 00 |  | 395 | =>x" | 00 | ",
 | 18C | 5D |  | 396 | =>x" | 5D | ",
 | 18D | 00 |  | 397 | =>x" | 00 | ",
 | 18E | 5D |  | 398 | =>x" | 5D | ",
 | 18F | 00 |  | 399 | =>x" | 00 | ",
 | 190 | 5D |  | 400 | =>x" | 5D | ",
 | 191 | 00 |  | 401 | =>x" | 00 | ",
 | 192 | 5D |  | 402 | =>x" | 5D | ",
 | 193 | 00 |  | 403 | =>x" | 00 | ",
 | 194 | 5D |  | 404 | =>x" | 5D | ",
 | 195 | 00 |  | 405 | =>x" | 00 | ",
 | 196 | 5D |  | 406 | =>x" | 5D | ",
 | 197 | 00 |  | 407 | =>x" | 00 | ",
 | 198 | 5D |  | 408 | =>x" | 5D | ",
 | 199 | 00 |  | 409 | =>x" | 00 | ",
 | 19A | 5D |  | 410 | =>x" | 5D | ",
 | 19B | 00 |  | 411 | =>x" | 00 | ",
 | 19C | 5D |  | 412 | =>x" | 5D | ",
 | 19D | 00 |  | 413 | =>x" | 00 | ",
 | 19E | 5D |  | 414 | =>x" | 5D | ",
 | 19F | 00 |  | 415 | =>x" | 00 | ",
 | 1A0 | 5D |  | 416 | =>x" | 5D | ",
 | 1A1 | 00 |  | 417 | =>x" | 00 | ",
 | 1A2 | 5D |  | 418 | =>x" | 5D | ",
 | 1A3 | 00 |  | 419 | =>x" | 00 | ",
 | 1A4 | 5D |  | 420 | =>x" | 5D | ",
 | 1A5 | 00 |  | 421 | =>x" | 00 | ",
 | 1A6 | 5D |  | 422 | =>x" | 5D | ",
 | 1A7 | 00 |  | 423 | =>x" | 00 | ",
 | 1A8 | 5D |  | 424 | =>x" | 5D | ",
 | 1A9 | 00 |  | 425 | =>x" | 00 | ",
 | 1AA | 5D |  | 426 | =>x" | 5D | ",
 | 1AB | 00 |  | 427 | =>x" | 00 | ",
 | 1AC | 5D |  | 428 | =>x" | 5D | ",
 | 1AD | 00 |  | 429 | =>x" | 00 | ",
 | 1AE | 5D |  | 430 | =>x" | 5D | ",
 | 1AF | 00 |  | 431 | =>x" | 00 | ",
 | 1B0 | 5D |  | 432 | =>x" | 5D | ",
 | 1B1 | 00 |  | 433 | =>x" | 00 | ",
 | 1B2 | 5D |  | 434 | =>x" | 5D | ",
 | 1B3 | 00 |  | 435 | =>x" | 00 | ",
 | 1B4 | 5D |  | 436 | =>x" | 5D | ",
 | 1B5 | 00 |  | 437 | =>x" | 00 | ",
 | 1B6 | 5D |  | 438 | =>x" | 5D | ",
 | 1B7 | 00 |  | 439 | =>x" | 00 | ",
 | 1B8 | 5D |  | 440 | =>x" | 5D | ",
 | 1B9 | 00 |  | 441 | =>x" | 00 | ",
 | 1BA | 5D |  | 442 | =>x" | 5D | ",
 | 1BB | 00 |  | 443 | =>x" | 00 | ",
 | 1BC | 5D |  | 444 | =>x" | 5D | ",
 | 1BD | 00 |  | 445 | =>x" | 00 | ",
 | 1BE | 5D |  | 446 | =>x" | 5D | ",
 | 1BF | 00 |  | 447 | =>x" | 00 | ",
 | 1C0 | 5D |  | 448 | =>x" | 5D | ",
 | 1C1 | 00 |  | 449 | =>x" | 00 | ",
 | 1C2 | 5D |  | 450 | =>x" | 5D | ",
 | 1C3 | 00 |  | 451 | =>x" | 00 | ",
 | 1C4 | 5D |  | 452 | =>x" | 5D | ",
 | 1C5 | 00 |  | 453 | =>x" | 00 | ",
 | 1C6 | 5D |  | 454 | =>x" | 5D | ",
 | 1C7 | 00 |  | 455 | =>x" | 00 | ",
 | 1C8 | 5D |  | 456 | =>x" | 5D | ",
 | 1C9 | 00 |  | 457 | =>x" | 00 | ",
 | 1CA | 5D |  | 458 | =>x" | 5D | ",
 | 1CB | 00 |  | 459 | =>x" | 00 | ",
 | 1CC | 5D |  | 460 | =>x" | 5D | ",
 | 1CD | 00 |  | 461 | =>x" | 00 | ",
 | 1CE | 5D |  | 462 | =>x" | 5D | ",
 | 1CF | 00 |  | 463 | =>x" | 00 | ",
 | 1D0 | 5D |  | 464 | =>x" | 5D | ",
 | 1D1 | 00 |  | 465 | =>x" | 00 | ",
 | 1D2 | 5D |  | 466 | =>x" | 5D | ",
 | 1D3 | 00 |  | 467 | =>x" | 00 | ",
 | 1D4 | 5D |  | 468 | =>x" | 5D | ",
 | 1D5 | 00 |  | 469 | =>x" | 00 | ",
 | 1D6 | 5D |  | 470 | =>x" | 5D | ",
 | 1D7 | 00 |  | 471 | =>x" | 00 | ",
 | 1D8 | 5D |  | 472 | =>x" | 5D | ",
 | 1D9 | 00 |  | 473 | =>x" | 00 | ",
 | 1DA | 5D |  | 474 | =>x" | 5D | ",
 | 1DB | 00 |  | 475 | =>x" | 00 | ",
 | 1DC | 5D |  | 476 | =>x" | 5D | ",
 | 1DD | 00 |  | 477 | =>x" | 00 | ",
 | 1DE | 5D |  | 478 | =>x" | 5D | ",
 | 1DF | 00 |  | 479 | =>x" | 00 | ",
 | 1E0 | 5D |  | 480 | =>x" | 5D | ",
 | 1E1 | 00 |  | 481 | =>x" | 00 | ",
 | 1E2 | 5D |  | 482 | =>x" | 5D | ",
 | 1E3 | 00 |  | 483 | =>x" | 00 | ",
 | 1E4 | 5D |  | 484 | =>x" | 5D | ",
 | 1E5 | 00 |  | 485 | =>x" | 00 | ",
 | 1E6 | 5D |  | 486 | =>x" | 5D | ",
 | 1E7 | 00 |  | 487 | =>x" | 00 | ",
 | 1E8 | 5D |  | 488 | =>x" | 5D | ",
 | 1E9 | 00 |  | 489 | =>x" | 00 | ",
 | 1EA | 5D |  | 490 | =>x" | 5D | ",
 | 1EB | 00 |  | 491 | =>x" | 00 | ",
 | 1EC | 5D |  | 492 | =>x" | 5D | ",
 | 1ED | 00 |  | 493 | =>x" | 00 | ",
 | 1EE | 5D |  | 494 | =>x" | 5D | ",
 | 1EF | 00 |  | 495 | =>x" | 00 | ",
 | 1F0 | 5D |  | 496 | =>x" | 5D | ",
 | 1F1 | 00 |  | 497 | =>x" | 00 | ",
 | 1F2 | 5D |  | 498 | =>x" | 5D | ",
 | 1F3 | 00 |  | 499 | =>x" | 00 | ",
 | 1F4 | 5D |  | 500 | =>x" | 5D | ",
 | 1F5 | 00 |  | 501 | =>x" | 00 | ",
 | 1F6 | 5D |  | 502 | =>x" | 5D | ",
 | 1F7 | 00 |  | 503 | =>x" | 00 | ",
 | 1F8 | 5D |  | 504 | =>x" | 5D | ",
 | 1F9 | 00 |  | 505 | =>x" | 00 | ",
 | 1FA | 5D |  | 506 | =>x" | 5D | ",
 | 1FB | 00 |  | 507 | =>x" | 00 | ",
 | 1FC | 5D |  | 508 | =>x" | 5D | ",
 | 1FD | 00 |  | 509 | =>x" | 00 | ",
 | 1FE | 5D |  | 510 | =>x" | 5D | ",
 | 1FF | 00 |  | 511 | =>x" | 00 | ",
 | 200 | 5D |  | 512 | =>x" | 5D | ",
 | 201 | 00 |  | 513 | =>x" | 00 | ",
 | 202 | 5D |  | 514 | =>x" | 5D | ",
 | 203 | 00 |  | 515 | =>x" | 00 | ",
 | 204 | 5D |  | 516 | =>x" | 5D | ",
 | 205 | 00 |  | 517 | =>x" | 00 | ",
 | 206 | 5D |  | 518 | =>x" | 5D | ",
 | 207 | 00 |  | 519 | =>x" | 00 | ",
 | 208 | 5D |  | 520 | =>x" | 5D | ",
 | 209 | 00 |  | 521 | =>x" | 00 | ",
 | 20A | 5D |  | 522 | =>x" | 5D | ",
 | 20B | 00 |  | 523 | =>x" | 00 | ",
 | 20C | 5D |  | 524 | =>x" | 5D | ",
 | 20D | 00 |  | 525 | =>x" | 00 | ",
 | 20E | 5D |  | 526 | =>x" | 5D | ",
 | 20F | 00 |  | 527 | =>x" | 00 | ",
 | 210 | 5D |  | 528 | =>x" | 5D | ",
 | 211 | 00 |  | 529 | =>x" | 00 | ",
 | 212 | 5D |  | 530 | =>x" | 5D | ",
 | 213 | 00 |  | 531 | =>x" | 00 | ",
 | 214 | 5D |  | 532 | =>x" | 5D | ",
 | 215 | 00 |  | 533 | =>x" | 00 | ",
 | 216 | 5D |  | 534 | =>x" | 5D | ",
 | 217 | 00 |  | 535 | =>x" | 00 | ",
 | 218 | 5D |  | 536 | =>x" | 5D | ",
 | 219 | 00 |  | 537 | =>x" | 00 | ",
 | 21A | 5D |  | 538 | =>x" | 5D | ",
 | 21B | 00 |  | 539 | =>x" | 00 | ",
 | 21C | 5D |  | 540 | =>x" | 5D | ",
 | 21D | 00 |  | 541 | =>x" | 00 | ",
 | 21E | 5D |  | 542 | =>x" | 5D | ",
 | 21F | 00 |  | 543 | =>x" | 00 | ",
 | 220 | 5D |  | 544 | =>x" | 5D | ",
 | 221 | 00 |  | 545 | =>x" | 00 | ",
 | 222 | 5D |  | 546 | =>x" | 5D | ",
 | 223 | 00 |  | 547 | =>x" | 00 | ",
 | 224 | 5D |  | 548 | =>x" | 5D | ",
 | 225 | 00 |  | 549 | =>x" | 00 | ",
 | 226 | 18 |  | 550 | =>x" | 18 | ",
 | 227 | 40 |  | 551 | =>x" | 40 | ",
 | 228 | 00 |  | 552 | =>x" | 00 | ",
 | 229 | F9 |  | 553 | =>x" | F9 | ",
 | 22A | 6B |  | 554 | =>x" | 6B | ",
 | 22B | 00 |  | 555 | =>x" | 00 | ",
 | 22C | EC |  | 556 | =>x" | EC | ",
 | 22D | 32 |  | 557 | =>x" | 32 | ",
 | 22E | 14 |  | 558 | =>x" | 14 | ",
 | 22F | 00 |  | 559 | =>x" | 00 | ",
 | 230 | E0 |  | 560 | =>x" | E0 | ",
 | 231 | 0E |  | 561 | =>x" | 0E | ",
 | 232 | 02 |  | 562 | =>x" | 02 | ",
 | 233 | 00 |  | 563 | =>x" | 00 | ",
 | 234 | 02 |  | 564 | =>x" | 02 | ",
 | 235 | 00 |  | 565 | =>x" | 00 | ",
 | 236 | 02 |  | 566 | =>x" | 02 | ",
 | 237 | 00 |  | 567 | =>x" | 00 | ",
 | 238 | 02 |  | 568 | =>x" | 02 | ",
 | 239 | 00 |  | 569 | =>x" | 00 | ",
 | 23A | 02 |  | 570 | =>x" | 02 | ",
 | 23B | 00 |  | 571 | =>x" | 00 | ",
 | 23C | 18 |  | 572 | =>x" | 18 | ",
 | 23D | 00 |  | 573 | =>x" | 00 | ",
 | 23E | 02 |  | 574 | =>x" | 02 | ",
 | 23F | 00 |  | 575 | =>x" | 00 | ",
 | 240 | 02 |  | 576 | =>x" | 02 | ",
 | 241 | 00 |  | 577 | =>x" | 00 | ",
 | 242 | 02 |  | 578 | =>x" | 02 | ",
 | 243 | 00 |  | 579 | =>x" | 00 | ",
 | 244 | 02 |  | 580 | =>x" | 02 | ",
 | 245 | 00 |  | 581 | =>x" | 00 | ",
 | 246 | 02 |  | 582 | =>x" | 02 | ",
 | 247 | 00 |  | 583 | =>x" | 00 | ",
 | 248 | 02 |  | 584 | =>x" | 02 | ",
 | 249 | 00 |  | 585 | =>x" | 00 | ",
 | 24A | 02 |  | 586 | =>x" | 02 | ",
 | 24B | 00 |  | 587 | =>x" | 00 | ",
 | 24C | 02 |  | 588 | =>x" | 02 | ",
 | 24D | 00 |  | 589 | =>x" | 00 | ",
 | 24E | 10 |  | 590 | =>x" | 10 | ",
 | 24F | F0 |  | 591 | =>x" | F0 | ",
 | 250 | FD |  | 592 | =>x" | FD | ",
 | 251 | 07 |  | 593 | =>x" | 07 | ",
 | 252 | 00 |  | 594 | =>x" | 00 | ",
 | 253 | 5E |  | 595 | =>x" | 5E | ",
 | 254 | C2 |  | 596 | =>x" | C2 | ",
 | 255 | 07 |  | 597 | =>x" | 07 | ",
 | 256 | 01 |  | 598 | =>x" | 01 | ",
 | 257 | 00 |  | 599 | =>x" | 00 | ",
 | 258 | 15 |  | 600 | =>x" | 15 | ",
 | 259 | 01 |  | 601 | =>x" | 01 | ",
 | 25A | 18 |  | 602 | =>x" | 18 | ",
 | 25B | 40 |  | 603 | =>x" | 40 | ",
 | 25C | E3 |  | 604 | =>x" | E3 | ",
 | 25D | 00 |  | 605 | =>x" | 00 | ",
 | 25E | 01 |  | 606 | =>x" | 01 | ",
 | 25F | 05 |  | 607 | =>x" | 05 | ",
 | 260 | 80 |  | 608 | =>x" | 80 | ",
 | 261 | 01 |  | 609 | =>x" | 01 | ",
 | 262 | C2 |  | 610 | =>x" | C2 | ",
 | 263 | 05 |  | 611 | =>x" | 05 | ",
 | 264 | 00 |  | 612 | =>x" | 00 | ",
 | 265 | 52 |  | 613 | =>x" | 52 | ",
 | 266 | 18 |  | 614 | =>x" | 18 | ",
 | 267 | 40 |  | 615 | =>x" | 40 | ",
 | 268 | C2 |  | 616 | =>x" | C2 | ",
 | 269 | 07 |  | 617 | =>x" | 07 | ",
 | 26A | 01 |  | 618 | =>x" | 01 | ",
 | 26B | 00 |  | 619 | =>x" | 00 | ",
 | 26C | 15 |  | 620 | =>x" | 15 | ",
 | 26D | 01 |  | 621 | =>x" | 01 | ",
 | 26E | E3 |  | 622 | =>x" | E3 | ",
 | 26F | 00 |  | 623 | =>x" | 00 | ",
END
