tocksin/gtxl/ltspice/RS170.asc

C1: cap; 100n
R1: res; 270
R2: res; 560
R3: res; 390
R4: res; 180
R5: res; 75
Vlum0: voltage; PULSE(0 3.3 0 1u 1u 2 4 1)
Vlum1: voltage; PULSE(0 3.3 0 1u 1u 1 2 2)
Vsync: voltage; PULSE(0 3.3 0 1u 1u 4 8)
Named nets: 0
.tran 7
Receiver
