tocksin/gtxl/pcb/gtxl/ALU.kicad_sch

## KiCad design pcb/gtxl/ALU.kicad_sch (2025-01-11)

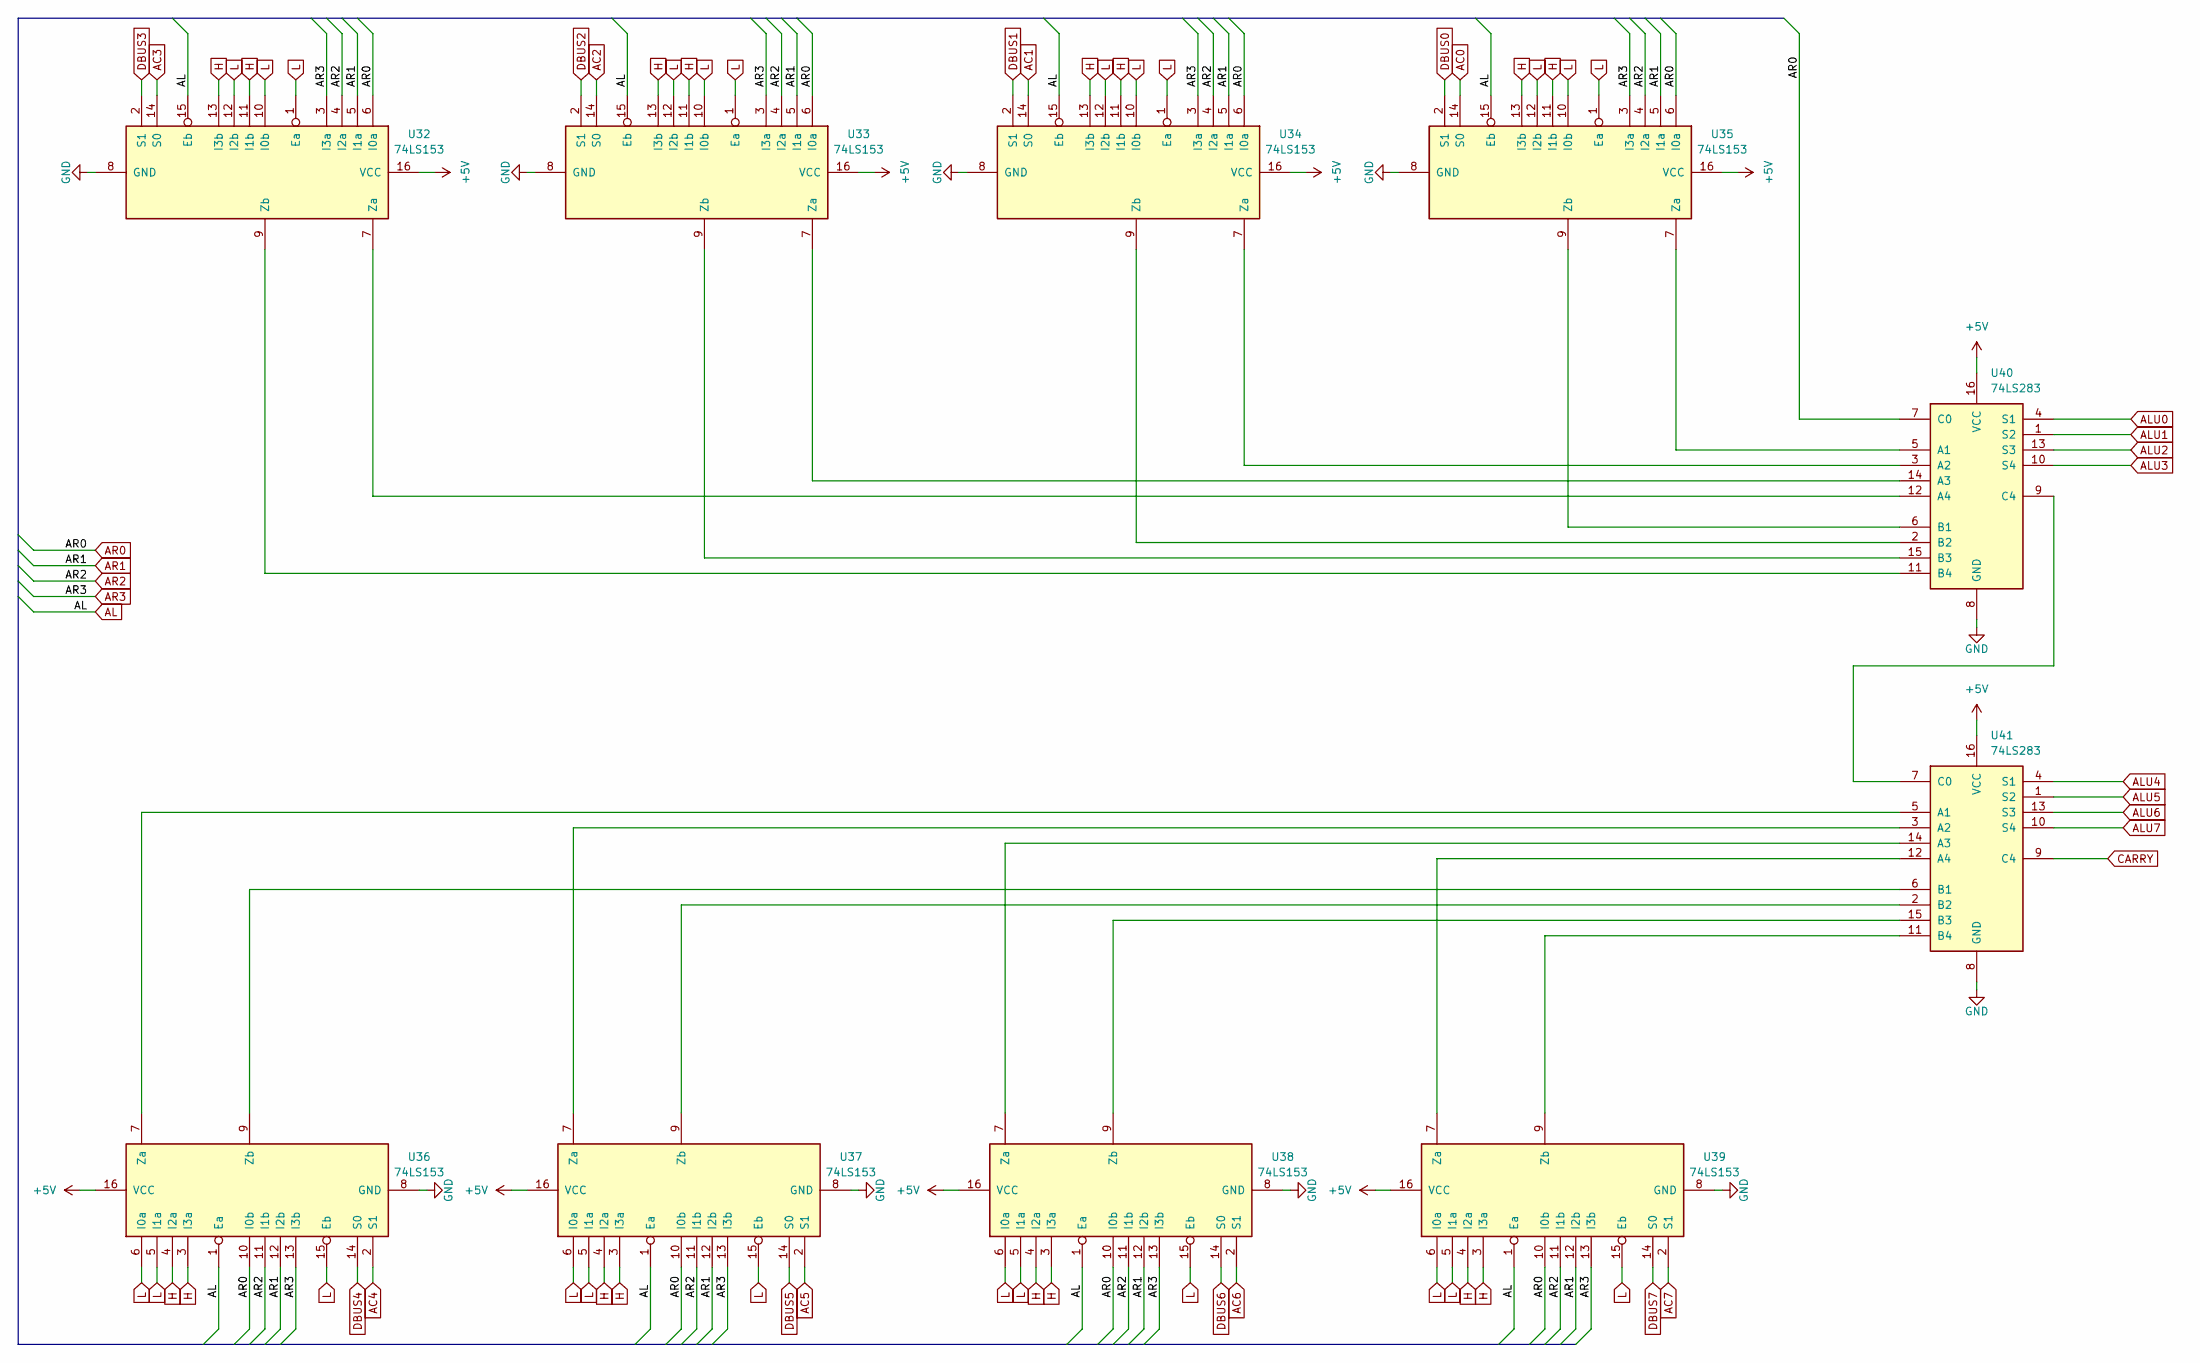
[picture p1: schematic ALU.kicad_sch]

Parts:
U32, U33, U34, U35, U36, U37, U38, U39: 74LS153
U40, U41: 74LS283

Connections:
+5V: U32.16 (VCC), U33.16 (VCC), U34.16 (VCC), U35.16 (VCC), U36.16 (VCC), U37.16 (VCC), U38.16 (VCC), U39.16 (VCC), U40.16 (VCC), U41.16 (VCC)
AC0: U35.14 (S0)
AC1: U34.14 (S0)
AC2: U33.14 (S0)
AC3: U32.14 (S0)
AC4: U36.2 (S1)
AC5: U37.2 (S1)
AC6: U38.2 (S1)
AC7: U39.2 (S1)
AL: U32.15 (Eb), U33.15 (Eb), U34.15 (Eb), U35.15 (Eb), U36.1 (Ea), U37.1 (Ea), U38.1 (Ea), U39.1 (Ea)
ALU0: U40.4 (S1)
ALU1: U40.1 (S2)
ALU2: U40.13 (S3)
ALU3: U40.10 (S4)
ALU4: U41.4 (S1)
ALU5: U41.1 (S2)
ALU6: U41.13 (S3)
ALU7: U41.10 (S4)
AR0: U32.6 (I0a), U33.6 (I0a), U34.6 (I0a), U35.6 (I0a), U36.10 (I0b), U37.10 (I0b), U38.10 (I0b), U39.10 (I0b), U40.7 (C0)
AR1: U32.5 (I1a), U33.5 (I1a), U34.5 (I1a), U35.5 (I1a), U36.12 (I2b), U37.12 (I2b), U38.12 (I2b), U39.12 (I2b)
AR2: U32.4 (I2a), U33.4 (I2a), U34.4 (I2a), U35.4 (I2a), U36.11 (I1b), U37.11 (I1b), U38.11 (I1b), U39.11 (I1b)
AR3: U32.3 (I3a), U33.3 (I3a), U34.3 (I3a), U35.3 (I3a), U36.13 (I3b), U37.13 (I3b), U38.13 (I3b), U39.13 (I3b)
CARRY: U41.9 (C4)
DBUS0: U35.2 (S1)
DBUS1: U34.2 (S1)
DBUS2: U33.2 (S1)
DBUS3: U32.2 (S1)
DBUS4: U36.14 (S0)
DBUS5: U37.14 (S0)
DBUS6: U38.14 (S0)
DBUS7: U39.14 (S0)
GND: U32.8 (GND), U33.8 (GND), U34.8 (GND), U35.8 (GND), U36.8 (GND), U37.8 (GND), U38.8 (GND), U39.8 (GND), U40.8 (GND), U41.8 (GND)
H: U32.11 (I1b), U32.13 (I3b), U33.11 (I1b), U33.13 (I3b), U34.11 (I1b), U34.13 (I3b), U35.11 (I1b), U35.13 (I3b), U36.3 (I3a), U36.4 (I2a), U37.3 (I3a), U37.4 (I2a), U38.3 (I3a), U38.4 (I2a), U39.3 (I3a), U39.4 (I2a)
L: U32.1 (Ea), U32.10 (I0b), U32.12 (I2b), U33.1 (Ea), U33.10 (I0b), U33.12 (I2b), U34.1 (Ea), U34.10 (I0b), U34.12 (I2b), U35.1 (Ea), U35.10 (I0b), U35.12 (I2b), U36.5 (I1a), U36.6 (I0a), U36.15 (Eb), U37.5 (I1a), U37.6 (I0a), U37.15 (Eb), U38.5 (I1a), U38.6 (I0a), U38.15 (Eb), U39.5 (I1a), U39.6 (I0a), U39.15 (Eb)
unnamed: U32.7 (Za), U40.12 (A4)
unnamed: U32.9 (Zb), U40.11 (B4)
unnamed: U33.7 (Za), U40.14 (A3)
unnamed: U33.9 (Zb), U40.15 (B3)
unnamed: U34.7 (Za), U40.3 (A2)
unnamed: U34.9 (Zb), U40.2 (B2)
unnamed: U35.7 (Za), U40.5 (A1)
unnamed: U35.9 (Zb), U40.6 (B1)
unnamed: U36.7 (Za), U41.5 (A1)
unnamed: U36.9 (Zb), U41.6 (B1)
unnamed: U37.7 (Za), U41.3 (A2)
unnamed: U37.9 (Zb), U41.2 (B2)
unnamed: U38.7 (Za), U41.14 (A3)
unnamed: U38.9 (Zb), U41.15 (B3)
unnamed: U39.7 (Za), U41.12 (A4)
unnamed: U39.9 (Zb), U41.11 (B4)
unnamed: U40.9 (C4), U41.7 (C0)
