tocksin/gtxl/pcb/gtxl/MAU.kicad_sch

## KiCad design pcb/gtxl/MAU.kicad_sch (2025-01-21, an earlier design)

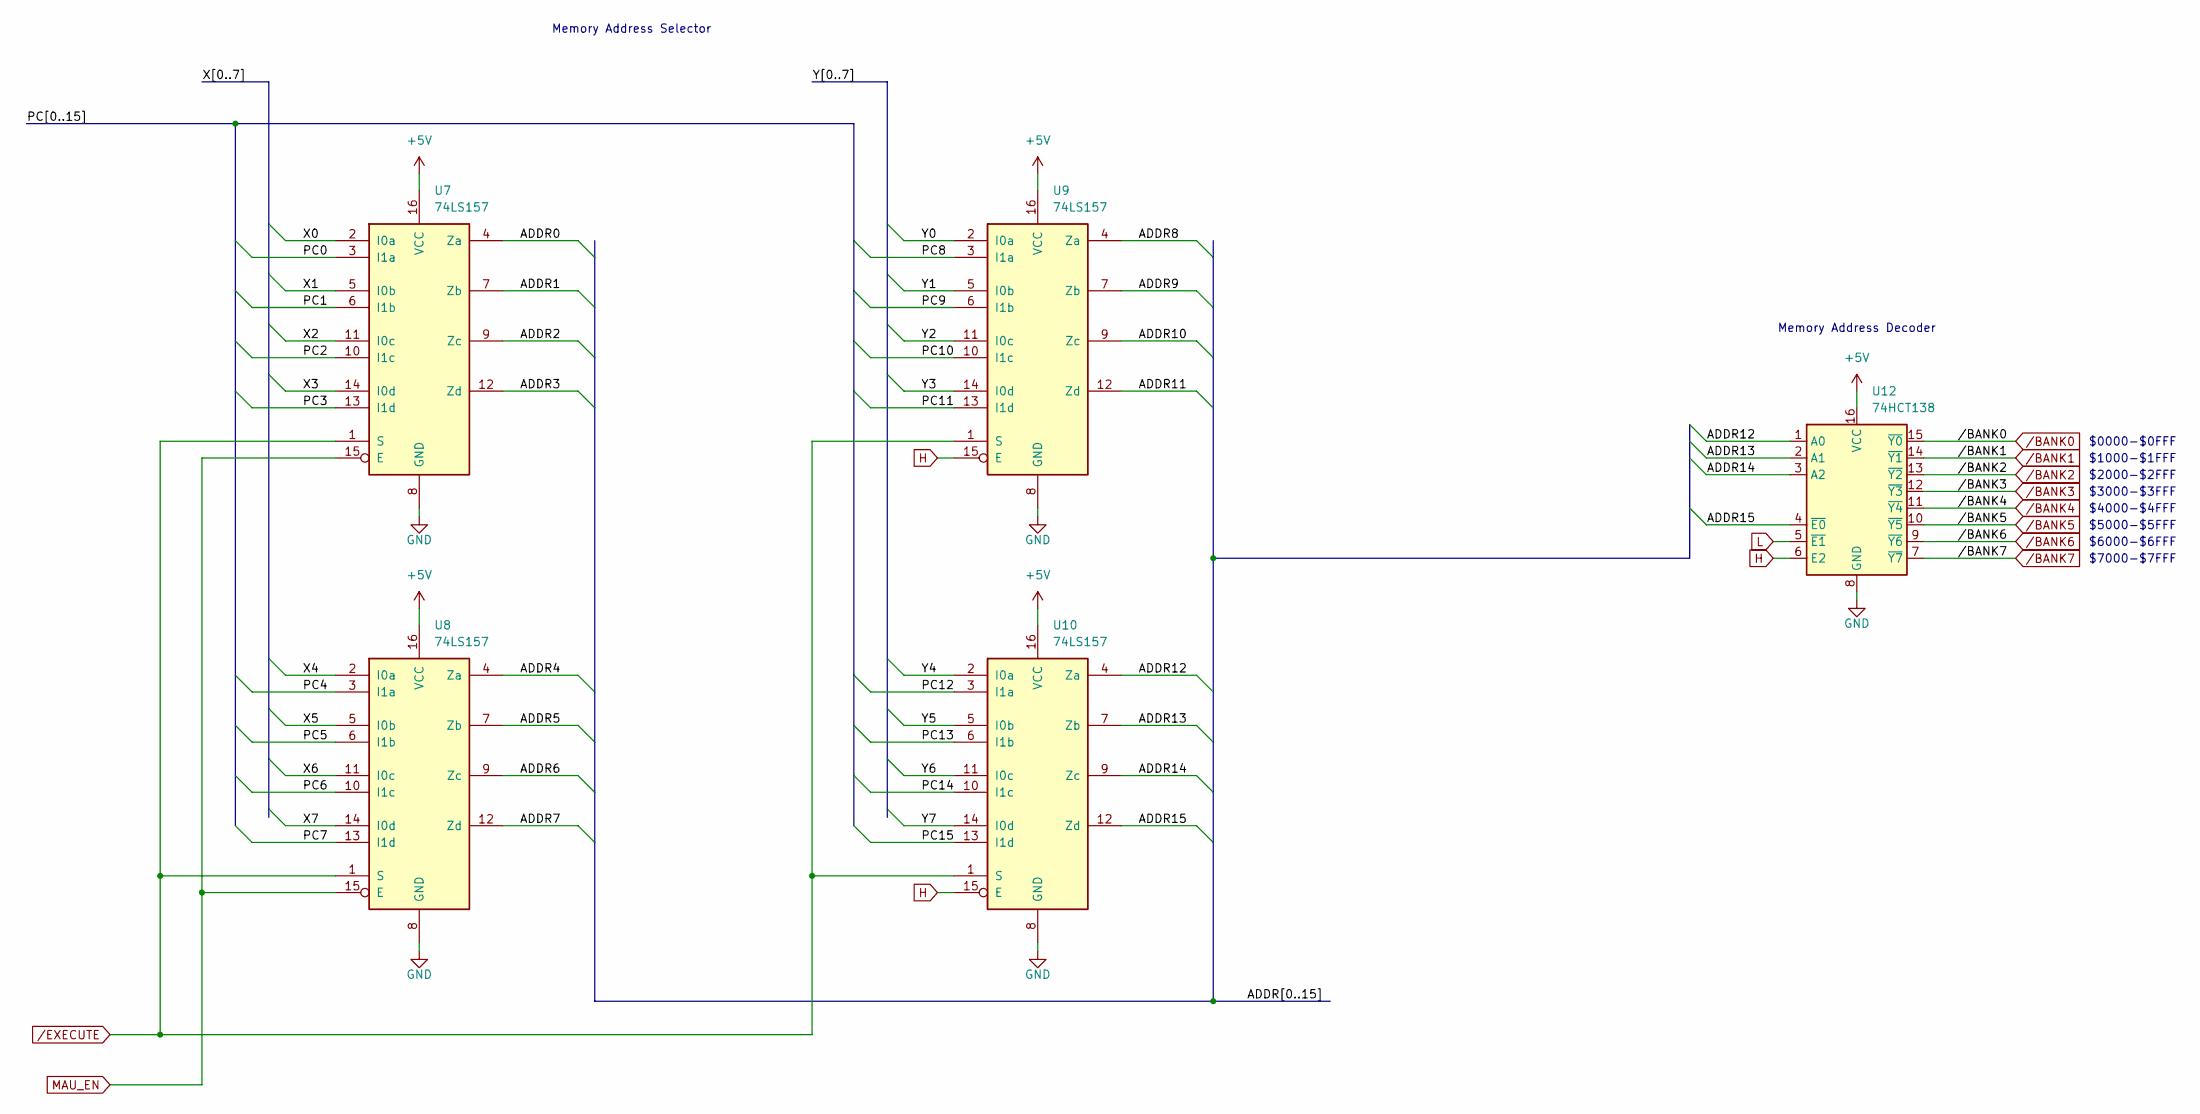
[picture p3: schematic MAU.kicad_sch]

Parts:
U7, U8, U9, U10: 74LS157
U12: 74HCT138

Connections:
+5V: U7.16 (VCC), U8.16 (VCC), U9.16 (VCC), U10.16 (VCC), U12.16 (VCC)
ADDR0: U7.4 (Za)
ADDR1: U7.7 (Zb)
ADDR2: U7.9 (Zc)
ADDR3: U7.12 (Zd)
ADDR4: U8.4 (Za)
ADDR5: U8.7 (Zb)
ADDR6: U8.9 (Zc)
ADDR7: U8.12 (Zd)
ADDR8: U9.4 (Za)
ADDR9: U9.7 (Zb)
ADDR10: U9.9 (Zc)
ADDR11: U9.12 (Zd)
ADDR12: U10.4 (Za), U12.1 (A0)
ADDR13: U10.7 (Zb), U12.2 (A1)
ADDR14: U10.9 (Zc), U12.3 (A2)
ADDR15: U10.12 (Zd), U12.4 (~E0)
GND: U7.8 (GND), U8.8 (GND), U9.8 (GND), U10.8 (GND), U12.8 (GND)
H: U9.15 (E), U10.15 (E), U12.6 (E2)
L: U12.5 (~E1)
MAU_EN: U7.15 (E), U8.15 (E)
PC0: U7.3 (I1a)
PC1: U7.6 (I1b)
PC2: U7.10 (I1c)
PC3: U7.13 (I1d)
PC4: U8.3 (I1a)
PC5: U8.6 (I1b)
PC6: U8.10 (I1c)
PC7: U8.13 (I1d)
PC8: U9.3 (I1a)
PC9: U9.6 (I1b)
PC10: U9.10 (I1c)
PC11: U9.13 (I1d)
PC12: U10.3 (I1a)
PC13: U10.6 (I1b)
PC14: U10.10 (I1c)
PC15: U10.13 (I1d)
X0: U7.2 (I0a)
X1: U7.5 (I0b)
X2: U7.11 (I0c)
X3: U7.14 (I0d)
X4: U8.2 (I0a)
X5: U8.5 (I0b)
X6: U8.11 (I0c)
X7: U8.14 (I0d)
Y0: U9.2 (I0a)
Y1: U9.5 (I0b)
Y2: U9.11 (I0c)
Y3: U9.14 (I0d)
Y4: U10.2 (I0a)
Y5: U10.5 (I0b)
Y6: U10.11 (I0c)
Y7: U10.14 (I0d)
/BANK0: U12.15 (~Y0)
/BANK1: U12.14 (~Y1)
/BANK2: U12.13 (~Y2)
/BANK3: U12.12 (~Y3)
/BANK4: U12.11 (~Y4)
/BANK5: U12.10 (~Y5)
/BANK6: U12.9 (~Y6)
/BANK7: U12.7 (~Y7)
/EXECUTE: U7.1 (S), U8.1 (S), U9.1 (S), U10.1 (S)

Notes on the sheet:
Memory Address Decoder
$7000-$7FFF
$1000-$1FFF
$6000-$6FFF
Memory Address Selector
$5000-$5FFF
$3000-$3FFF
$2000-$2FFF
$0000-$0FFF
$4000-$4FFF
