tocksin/gtxl/pcb/gtxl/MEM.kicad_sch

## KiCad design pcb/gtxl/MEM.kicad_sch (2025-01-21, an earlier design)

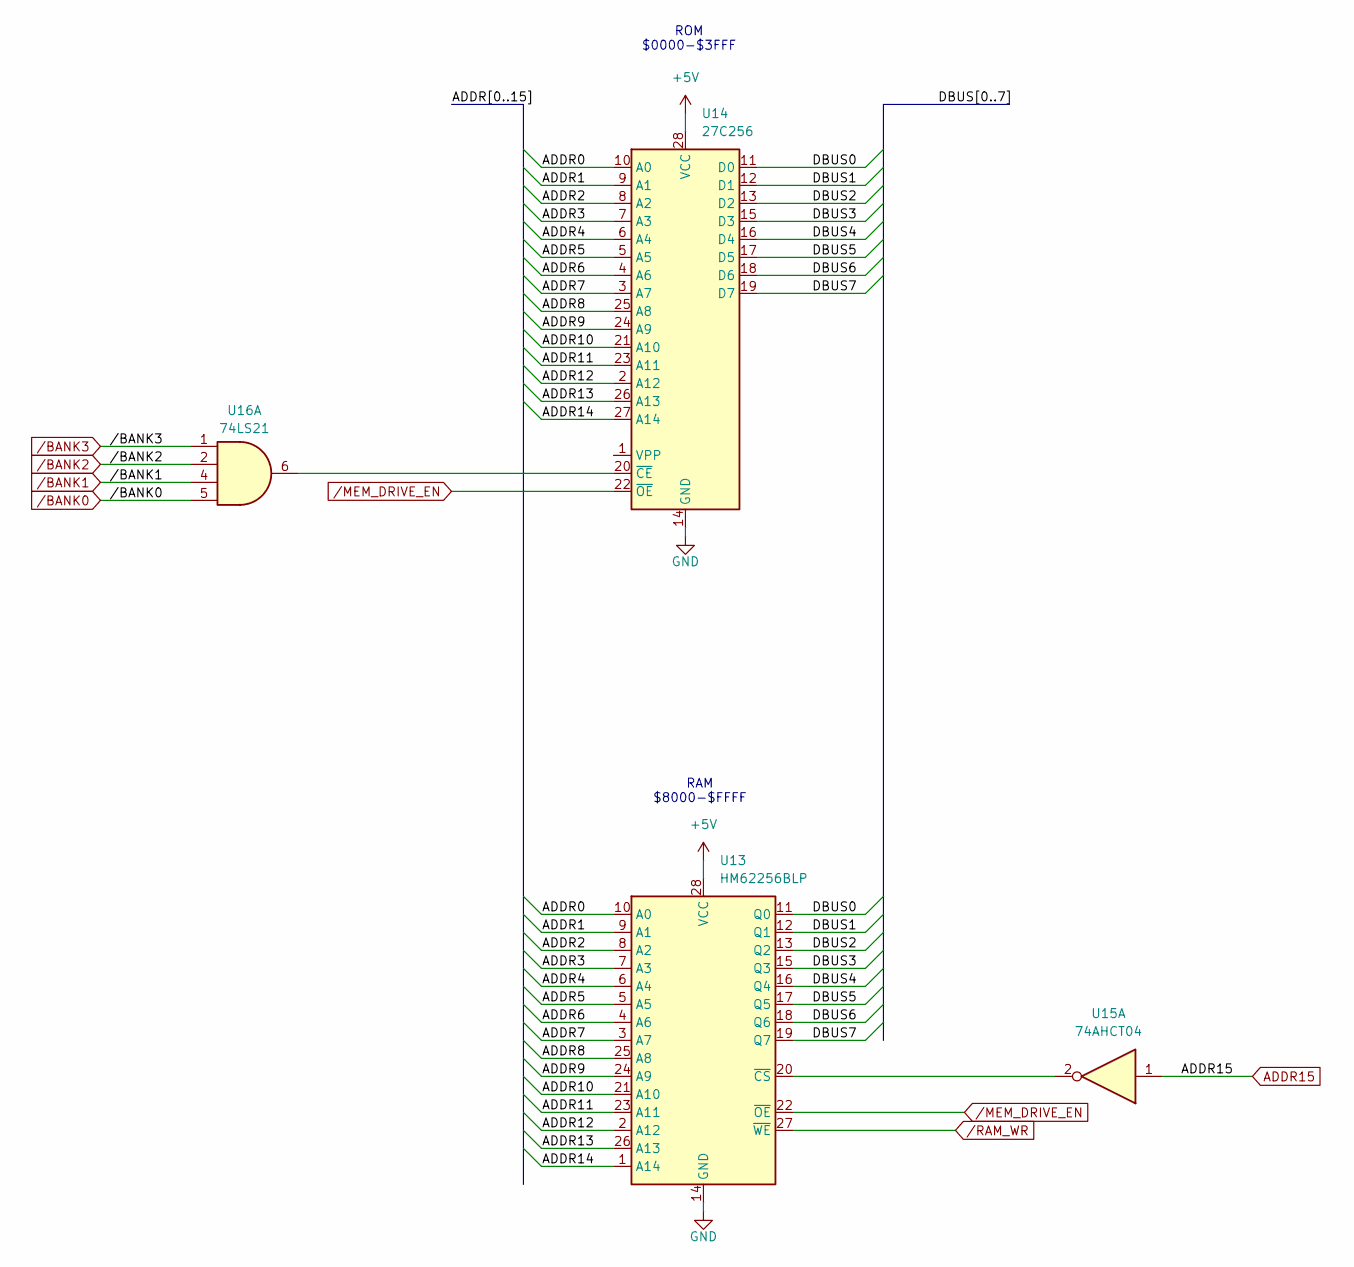
[picture p4: schematic MEM.kicad_sch]

Parts:
U13: HM62256BLP; DIP-28_W15.24mm
U14: 27C256; DIP-28_W15.24mm
U15: 74AHCT04
U16: 74LS21

Connections:
+5V: U13.28 (VCC), U14.28 (VCC)
ADDR0: U13.10 (A0), U14.10 (A0)
ADDR1: U13.9 (A1), U14.9 (A1)
ADDR2: U13.8 (A2), U14.8 (A2)
ADDR3: U13.7 (A3), U14.7 (A3)
ADDR4: U13.6 (A4), U14.6 (A4)
ADDR5: U13.5 (A5), U14.5 (A5)
ADDR6: U13.4 (A6), U14.4 (A6)
ADDR7: U13.3 (A7), U14.3 (A7)
ADDR8: U13.25 (A8), U14.25 (A8)
ADDR9: U13.24 (A9), U14.24 (A9)
ADDR10: U13.21 (A10), U14.21 (A10)
ADDR11: U13.23 (A11), U14.23 (A11)
ADDR12: U13.2 (A12), U14.2 (A12)
ADDR13: U13.26 (A13), U14.26 (A13)
ADDR14: U13.1 (A14), U14.27 (A14)
ADDR15: U15.1
DBUS0: U13.11 (Q0), U14.11 (D0)
DBUS1: U13.12 (Q1), U14.12 (D1)
DBUS2: U13.13 (Q2), U14.13 (D2)
DBUS3: U13.15 (Q3), U14.15 (D3)
DBUS4: U13.16 (Q4), U14.16 (D4)
DBUS5: U13.17 (Q5), U14.17 (D5)
DBUS6: U13.18 (Q6), U14.18 (D6)
DBUS7: U13.19 (Q7), U14.19 (D7)
GND: U13.14 (GND), U14.14 (GND)
unnamed: U13.20 (~CS), U15.2
unnamed: U14.20 (~CE), U16.6
/BANK0: U16.5
/BANK1: U16.4
/BANK2: U16.2
/BANK3: U16.1
/MEM_DRIVE_EN: U13.22 (~OE), U14.22 (~OE)
/RAM_WR: U13.27 (~WE)

Notes on the sheet:
RAM $8000-$FFFF
ROM $0000-$3FFF
