tocksin/gtxl/pcb/gtxl/PC.kicad_sch

## KiCad design pcb/gtxl/PC.kicad_sch (2025-01-21, an earlier design)

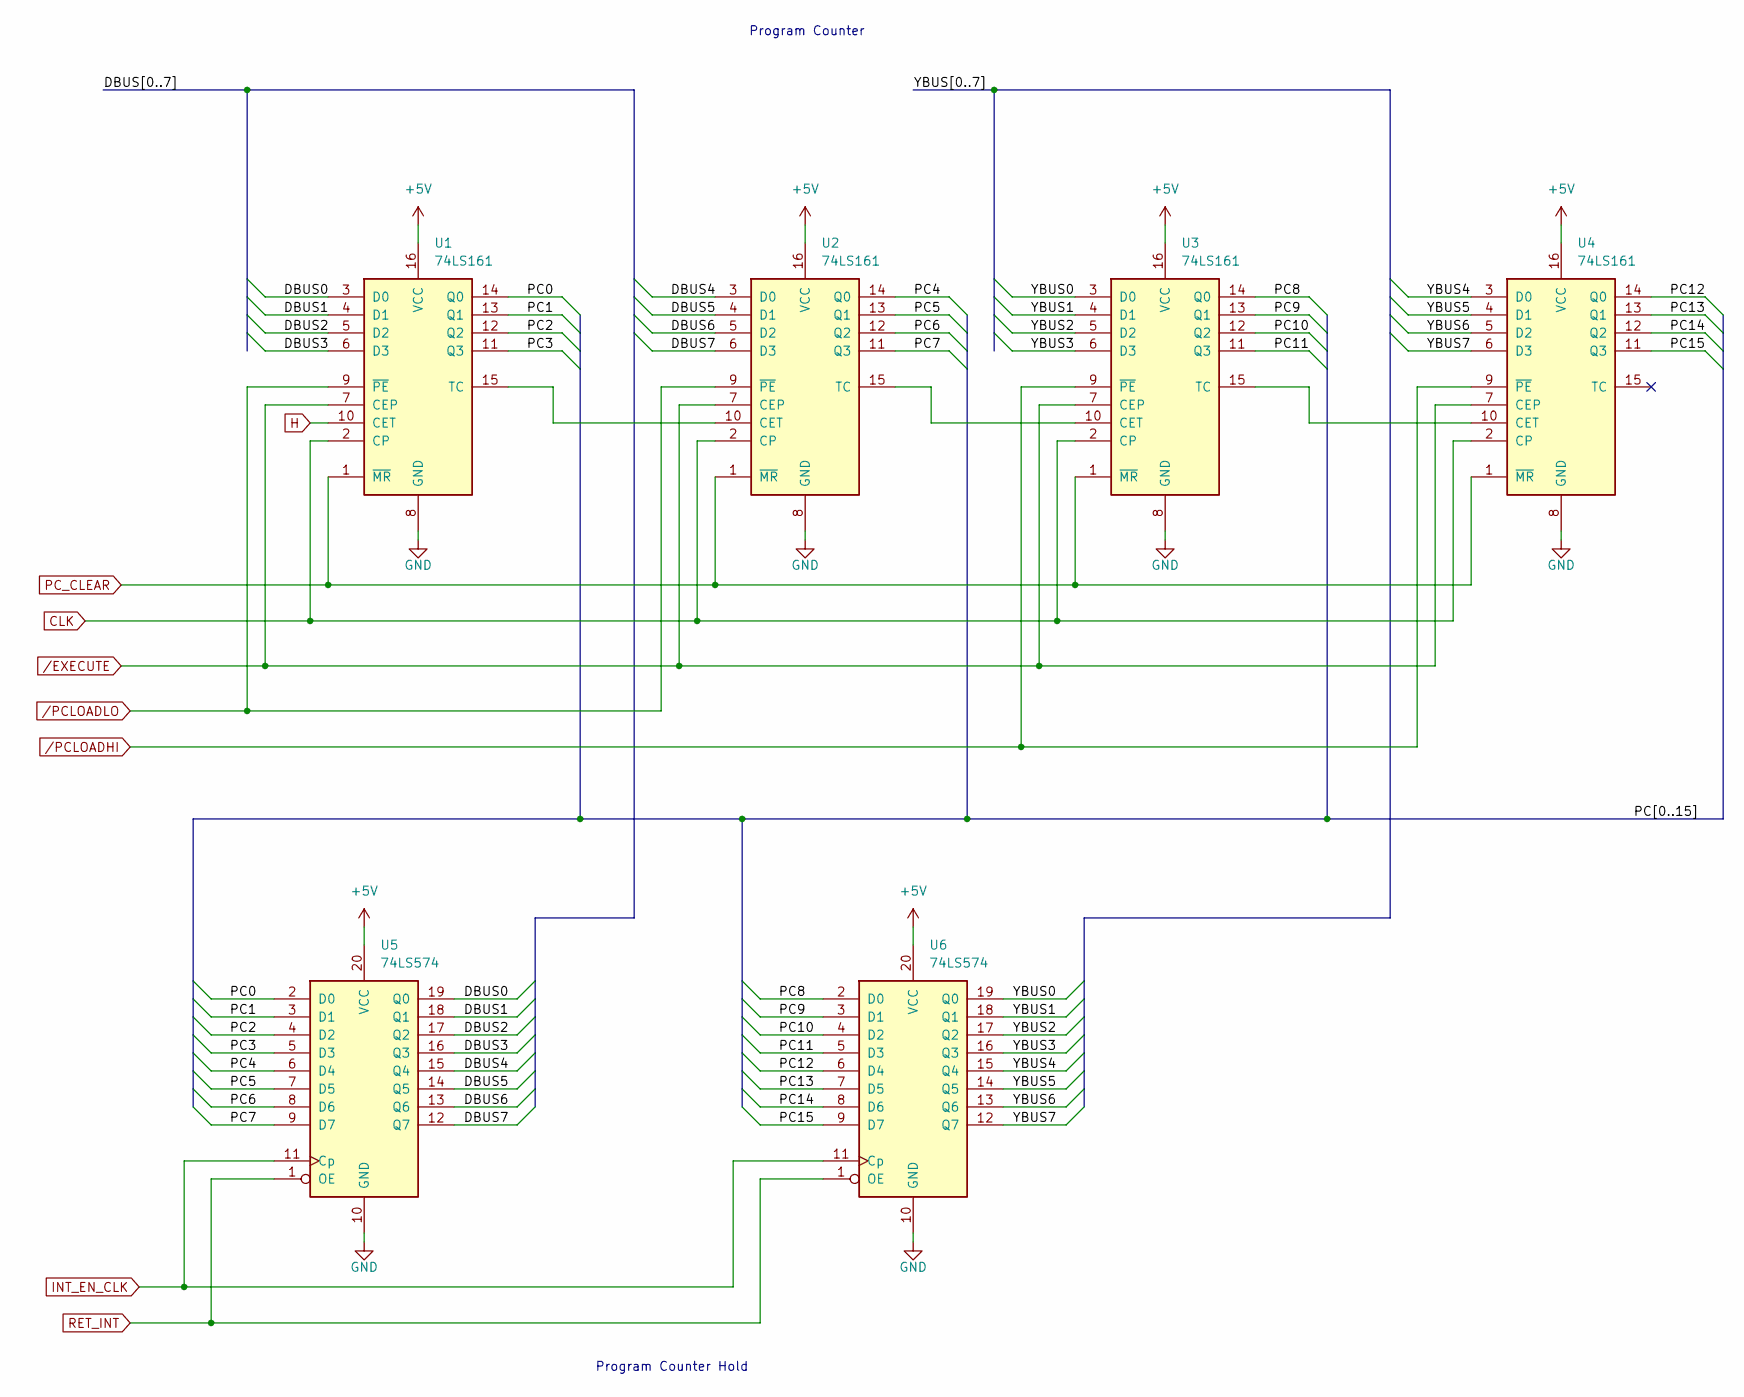
[picture p5: schematic PC.kicad_sch]

Parts:
U1, U2, U3, U4: 74LS161
U5, U6: 74LS574

Connections:
+5V: U1.16 (VCC), U2.16 (VCC), U3.16 (VCC), U4.16 (VCC), U5.20 (VCC), U6.20 (VCC)
CLK: U1.2 (CP), U2.2 (CP), U3.2 (CP), U4.2 (CP)
DBUS0: U1.3 (D0), U5.19 (Q0)
DBUS1: U1.4 (D1), U5.18 (Q1)
DBUS2: U1.5 (D2), U5.17 (Q2)
DBUS3: U1.6 (D3), U5.16 (Q3)
DBUS4: U2.3 (D0), U5.15 (Q4)
DBUS5: U2.4 (D1), U5.14 (Q5)
DBUS6: U2.5 (D2), U5.13 (Q6)
DBUS7: U2.6 (D3), U5.12 (Q7)
GND: U1.8 (GND), U2.8 (GND), U3.8 (GND), U4.8 (GND), U5.10 (GND), U6.10 (GND)
H: U1.10 (CET)
INT_EN_CLK: U5.11 (Cp), U6.11 (Cp)
unnamed: U1.15 (TC), U2.10 (CET)
unnamed: U2.15 (TC), U3.10 (CET)
unnamed: U3.15 (TC), U4.10 (CET)
PC0: U1.14 (Q0), U5.2 (D0)
PC1: U1.13 (Q1), U5.3 (D1)
PC2: U1.12 (Q2), U5.4 (D2)
PC3: U1.11 (Q3), U5.5 (D3)
PC4: U2.14 (Q0), U5.6 (D4)
PC5: U2.13 (Q1), U5.7 (D5)
PC6: U2.12 (Q2), U5.8 (D6)
PC7: U2.11 (Q3), U5.9 (D7)
PC8: U3.14 (Q0), U6.2 (D0)
PC9: U3.13 (Q1), U6.3 (D1)
PC10: U3.12 (Q2), U6.4 (D2)
PC11: U3.11 (Q3), U6.5 (D3)
PC12: U4.14 (Q0), U6.6 (D4)
PC13: U4.13 (Q1), U6.7 (D5)
PC14: U4.12 (Q2), U6.8 (D6)
PC15: U4.11 (Q3), U6.9 (D7)
PC_CLEAR: U1.1 (~MR), U2.1 (~MR), U3.1 (~MR), U4.1 (~MR)
RET_INT: U5.1 (OE), U6.1 (OE)
YBUS0: U3.3 (D0), U6.19 (Q0)
YBUS1: U3.4 (D1), U6.18 (Q1)
YBUS2: U3.5 (D2), U6.17 (Q2)
YBUS3: U3.6 (D3), U6.16 (Q3)
YBUS4: U4.3 (D0), U6.15 (Q4)
YBUS5: U4.4 (D1), U6.14 (Q5)
YBUS6: U4.5 (D2), U6.13 (Q6)
YBUS7: U4.6 (D3), U6.12 (Q7)
/EXECUTE: U1.7 (CEP), U2.7 (CEP), U3.7 (CEP), U4.7 (CEP)
/PCLOADHI: U3.9 (~PE), U4.9 (~PE)
/PCLOADLO: U1.9 (~PE), U2.9 (~PE)

Notes on the sheet:
Program Counter
Program Counter Hold
