tocksin/gtxl/pcb/gtxl/REGS.kicad_sch

## KiCad design pcb/gtxl/REGS.kicad_sch (2025-01-21, an earlier design)

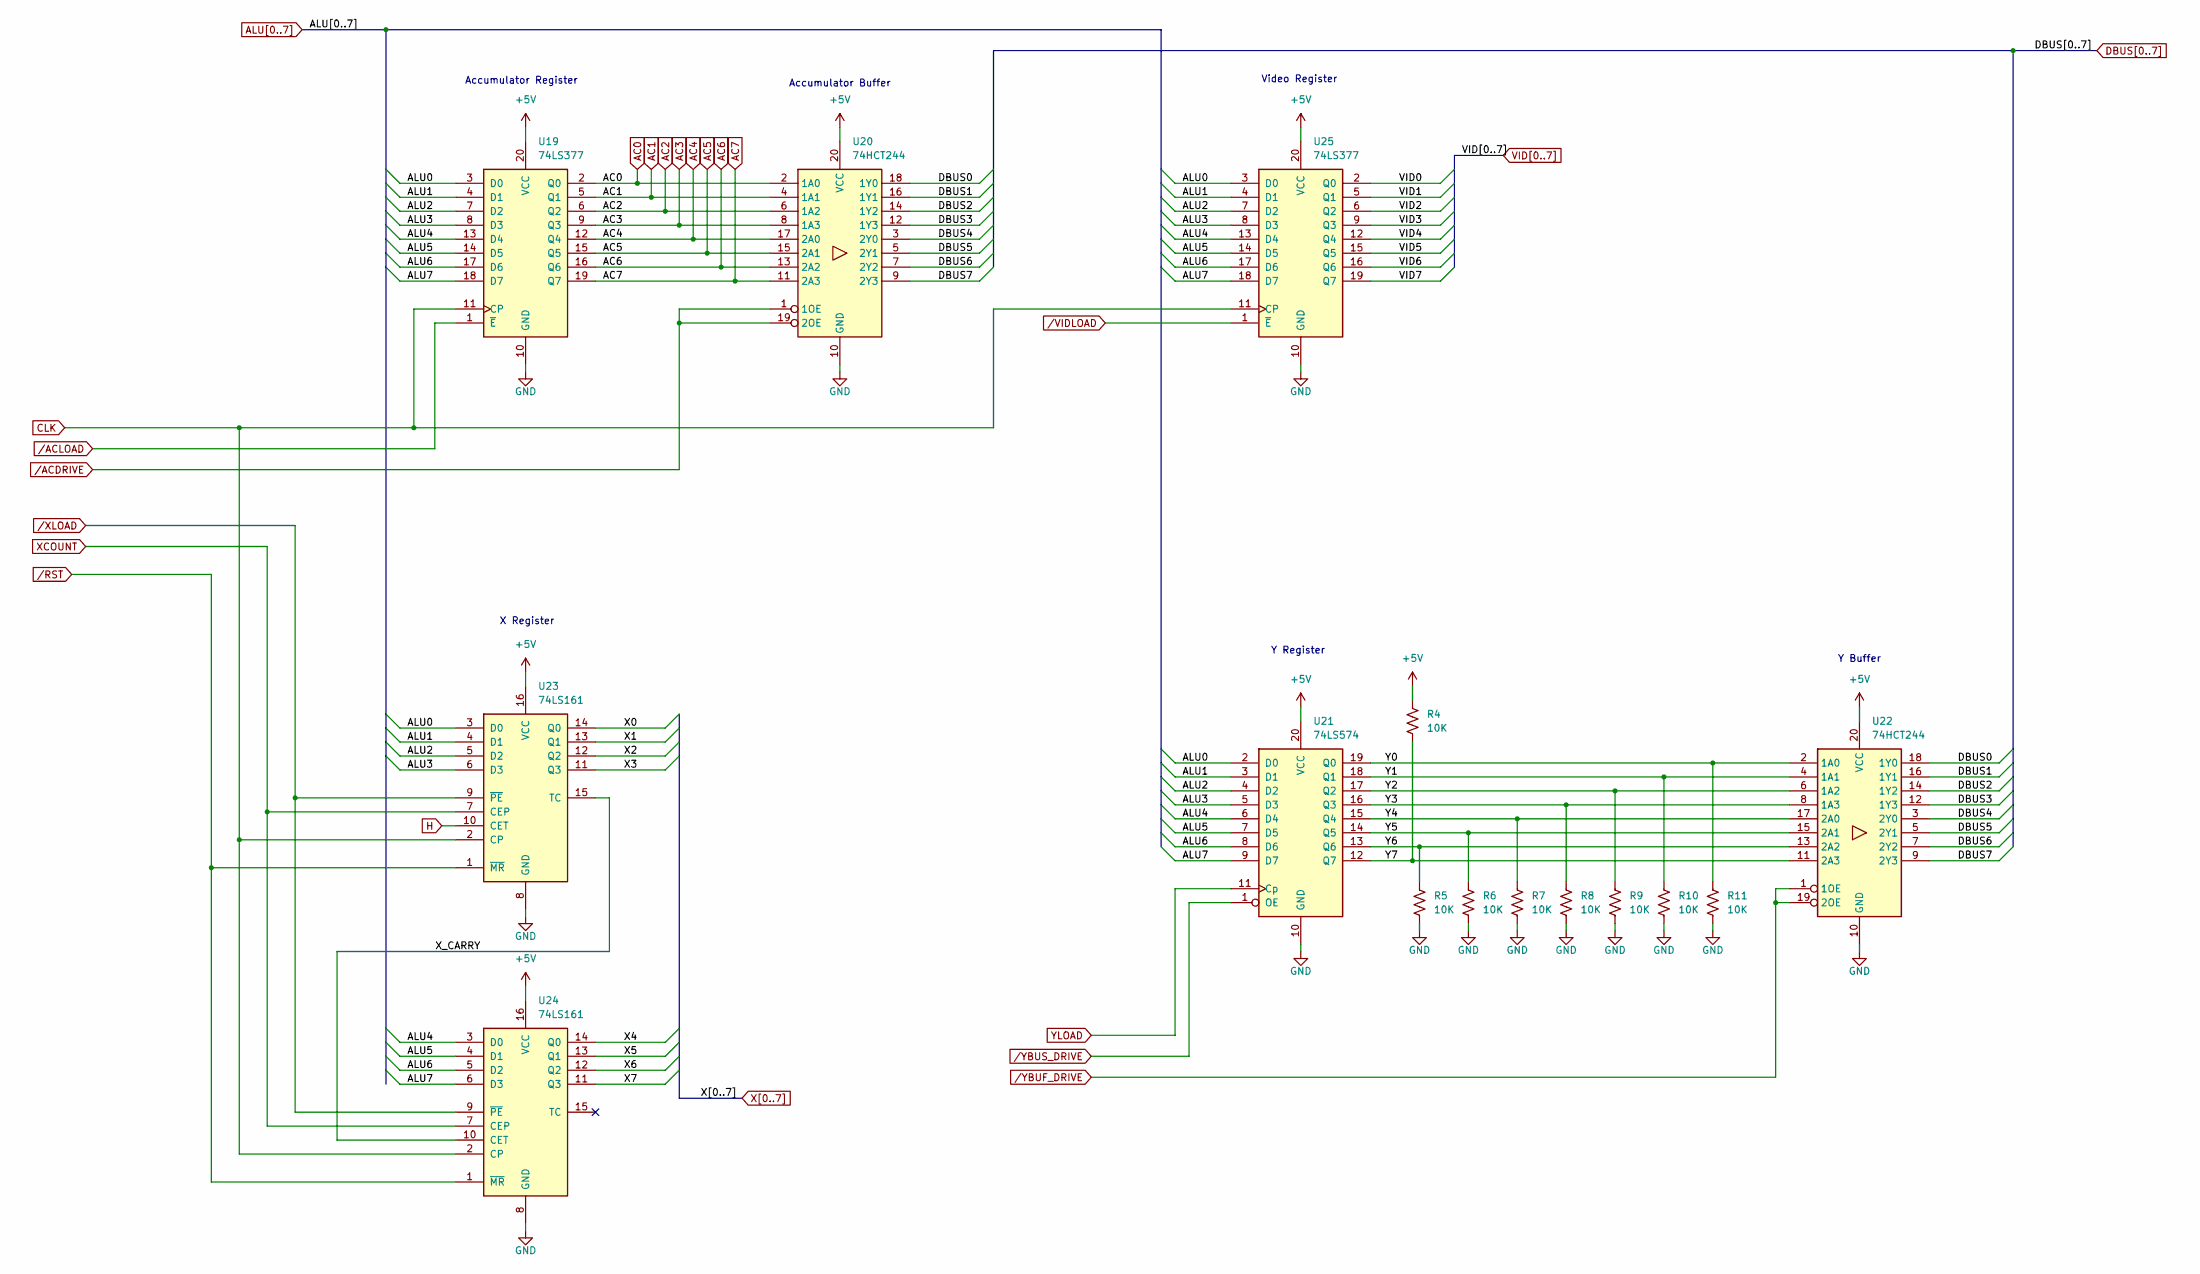
[picture p6: schematic REGS.kicad_sch]

Parts:
R4, R5, R6, R7, R8, R9, R10, R11: 10K
U19, U25: 74LS377
U20, U22: 74HCT244
U21: 74LS574
U23, U24: 74LS161

Connections:
+5V: R4.1, U19.20 (VCC), U20.20 (VCC), U21.20 (VCC), U22.20 (VCC), U23.16 (VCC), U24.16 (VCC), U25.20 (VCC)
AC0: U19.2 (Q0), U20.2 (1A0)
AC1: U19.5 (Q1), U20.4 (1A1)
AC2: U19.6 (Q2), U20.6 (1A2)
AC3: U19.9 (Q3), U20.8 (1A3)
AC4: U19.12 (Q4), U20.17 (2A0)
AC5: U19.15 (Q5), U20.15 (2A1)
AC6: U19.16 (Q6), U20.13 (2A2)
AC7: U19.19 (Q7), U20.11 (2A3)
ALU0: U19.3 (D0), U21.2 (D0), U23.3 (D0), U25.3 (D0)
ALU1: U19.4 (D1), U21.3 (D1), U23.4 (D1), U25.4 (D1)
ALU2: U19.7 (D2), U21.4 (D2), U23.5 (D2), U25.7 (D2)
ALU3: U19.8 (D3), U21.5 (D3), U23.6 (D3), U25.8 (D3)
ALU4: U19.13 (D4), U21.6 (D4), U24.3 (D0), U25.13 (D4)
ALU5: U19.14 (D5), U21.7 (D5), U24.4 (D1), U25.14 (D5)
ALU6: U19.17 (D6), U21.8 (D6), U24.5 (D2), U25.17 (D6)
ALU7: U19.18 (D7), U21.9 (D7), U24.6 (D3), U25.18 (D7)
CLK: U19.11 (CP), U23.2 (CP), U24.2 (CP), U25.11 (CP)
DBUS0: U20.18 (1Y0), U22.18 (1Y0)
DBUS1: U20.16 (1Y1), U22.16 (1Y1)
DBUS2: U20.14 (1Y2), U22.14 (1Y2)
DBUS3: U20.12 (1Y3), U22.12 (1Y3)
DBUS4: U20.3 (2Y0), U22.3 (2Y0)
DBUS5: U20.5 (2Y1), U22.5 (2Y1)
DBUS6: U20.7 (2Y2), U22.7 (2Y2)
DBUS7: U20.9 (2Y3), U22.9 (2Y3)
GND: R5.2, R6.2, R7.2, R8.2, R9.2, R10.2, R11.2, U19.10 (GND), U20.10 (GND), U21.10 (GND), U22.10 (GND), U23.8 (GND), U24.8 (GND), U25.10 (GND)
H: U23.10 (CET)
VID0: U25.2 (Q0)
VID1: U25.5 (Q1)
VID2: U25.6 (Q2)
VID3: U25.9 (Q3)
VID4: U25.12 (Q4)
VID5: U25.15 (Q5)
VID6: U25.16 (Q6)
VID7: U25.19 (Q7)
X0: U23.14 (Q0)
X1: U23.13 (Q1)
X2: U23.12 (Q2)
X3: U23.11 (Q3)
X4: U24.14 (Q0)
X5: U24.13 (Q1)
X6: U24.12 (Q2)
X7: U24.11 (Q3)
XCOUNT: U23.7 (CEP), U24.7 (CEP)
X_CARRY: U23.15 (TC), U24.10 (CET)
Y0: R11.1, U21.19 (Q0), U22.2 (1A0)
Y1: R10.1, U21.18 (Q1), U22.4 (1A1)
Y2: R9.1, U21.17 (Q2), U22.6 (1A2)
Y3: R8.1, U21.16 (Q3), U22.8 (1A3)
Y4: R7.1, U21.15 (Q4), U22.17 (2A0)
Y5: R6.1, U21.14 (Q5), U22.15 (2A1)
Y6: R5.1, U21.13 (Q6), U22.13 (2A2)
Y7: R4.2, U21.12 (Q7), U22.11 (2A3)
YLOAD: U21.11 (Cp)
/ACDRIVE: U20.1 (1OE), U20.19 (2OE)
/ACLOAD: U19.1 (~E)
/RST: U23.1 (~MR), U24.1 (~MR)
/VIDLOAD: U25.1 (~E)
/XLOAD: U23.9 (~PE), U24.9 (~PE)
/YBUF_DRIVE: U22.1 (1OE), U22.19 (2OE)
/YBUS_DRIVE: U21.1 (OE)

Notes on the sheet:
Accumulator Register
X Register
Accumulator Buffer
Video Register
Y Register
Y Buffer
