tocksin/gtxl/pcb/gtxl/STATE.kicad_sch

## KiCad design pcb/gtxl/STATE.kicad_sch (2025-01-21, an earlier design)

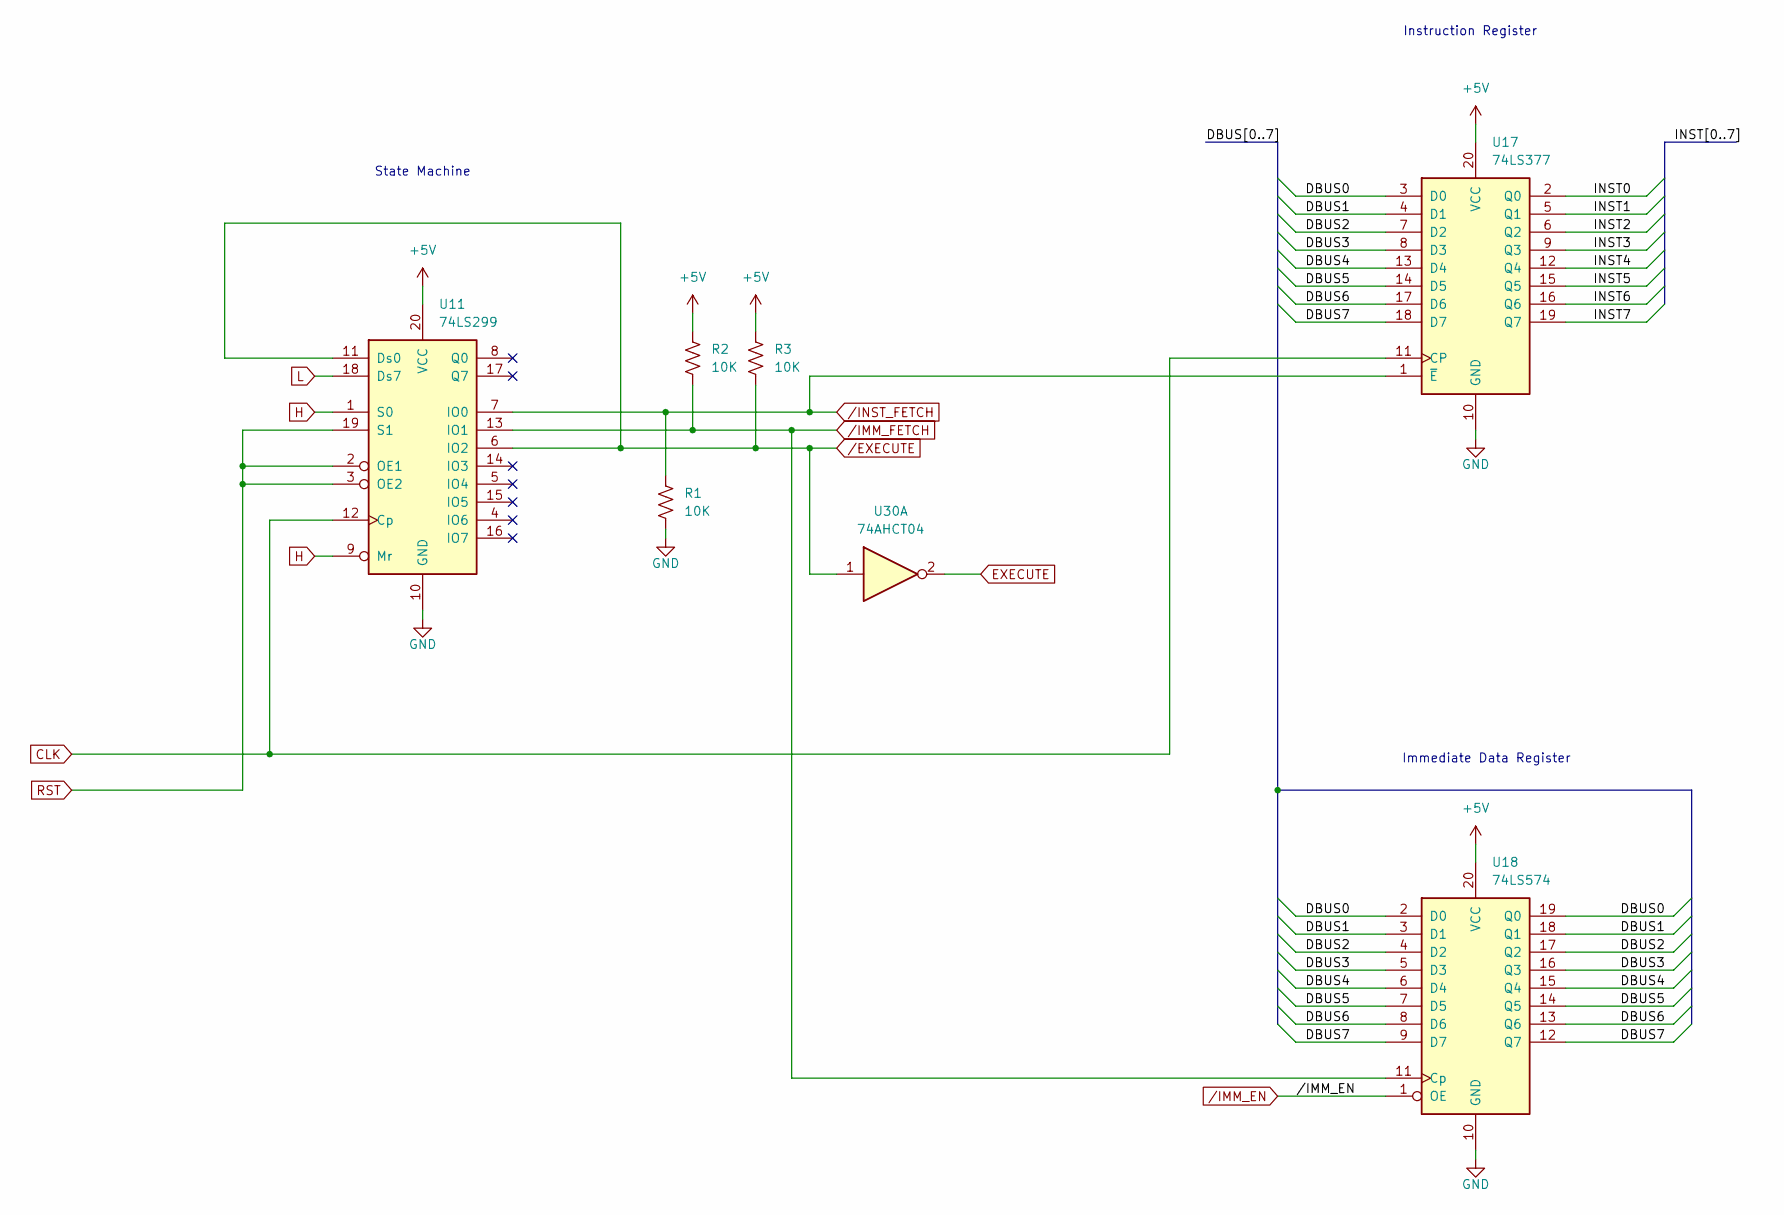
[picture p7: schematic STATE.kicad_sch]

Parts:
R1, R2, R3: 10K
U11: 74LS299
U17: 74LS377
U18: 74LS574
U30: 74AHCT04

Connections:
+5V: R2.1, R3.1, U11.20 (VCC), U17.20 (VCC), U18.20 (VCC)
CLK: U11.12 (Cp), U17.11 (CP)
DBUS0: U17.3 (D0), U18.2 (D0), U18.19 (Q0)
DBUS1: U17.4 (D1), U18.3 (D1), U18.18 (Q1)
DBUS2: U17.7 (D2), U18.4 (D2), U18.17 (Q2)
DBUS3: U17.8 (D3), U18.5 (D3), U18.16 (Q3)
DBUS4: U17.13 (D4), U18.6 (D4), U18.15 (Q4)
DBUS5: U17.14 (D5), U18.7 (D5), U18.14 (Q5)
DBUS6: U17.17 (D6), U18.8 (D6), U18.13 (Q6)
DBUS7: U17.18 (D7), U18.9 (D7), U18.12 (Q7)
EXECUTE: U30.2
GND: R1.2, U11.10 (GND), U17.10 (GND), U18.10 (GND)
H: U11.1 (S0), U11.9 (Mr)
INST0: U17.2 (Q0)
INST1: U17.5 (Q1)
INST2: U17.6 (Q2)
INST3: U17.9 (Q3)
INST4: U17.12 (Q4)
INST5: U17.15 (Q5)
INST6: U17.16 (Q6)
INST7: U17.19 (Q7)
L: U11.18 (Ds7)
RST: U11.2 (OE1), U11.3 (OE2), U11.19 (S1)
/EXECUTE: R3.2, U11.6 (IO2), U11.11 (Ds0), U30.1
/IMM_EN: U18.1 (OE)
/IMM_FETCH: R2.2, U11.13 (IO1), U18.11 (Cp)
/INST_FETCH: R1.1, U11.7 (IO0), U17.1 (~E)

Notes on the sheet:
State Machine
Instruction Register
Immediate Data Register
