tocksin/gtxl/pcb/gtxl/TIMER.kicad_sch

## KiCad design pcb/gtxl/TIMER.kicad_sch (2025-01-21, an earlier design)

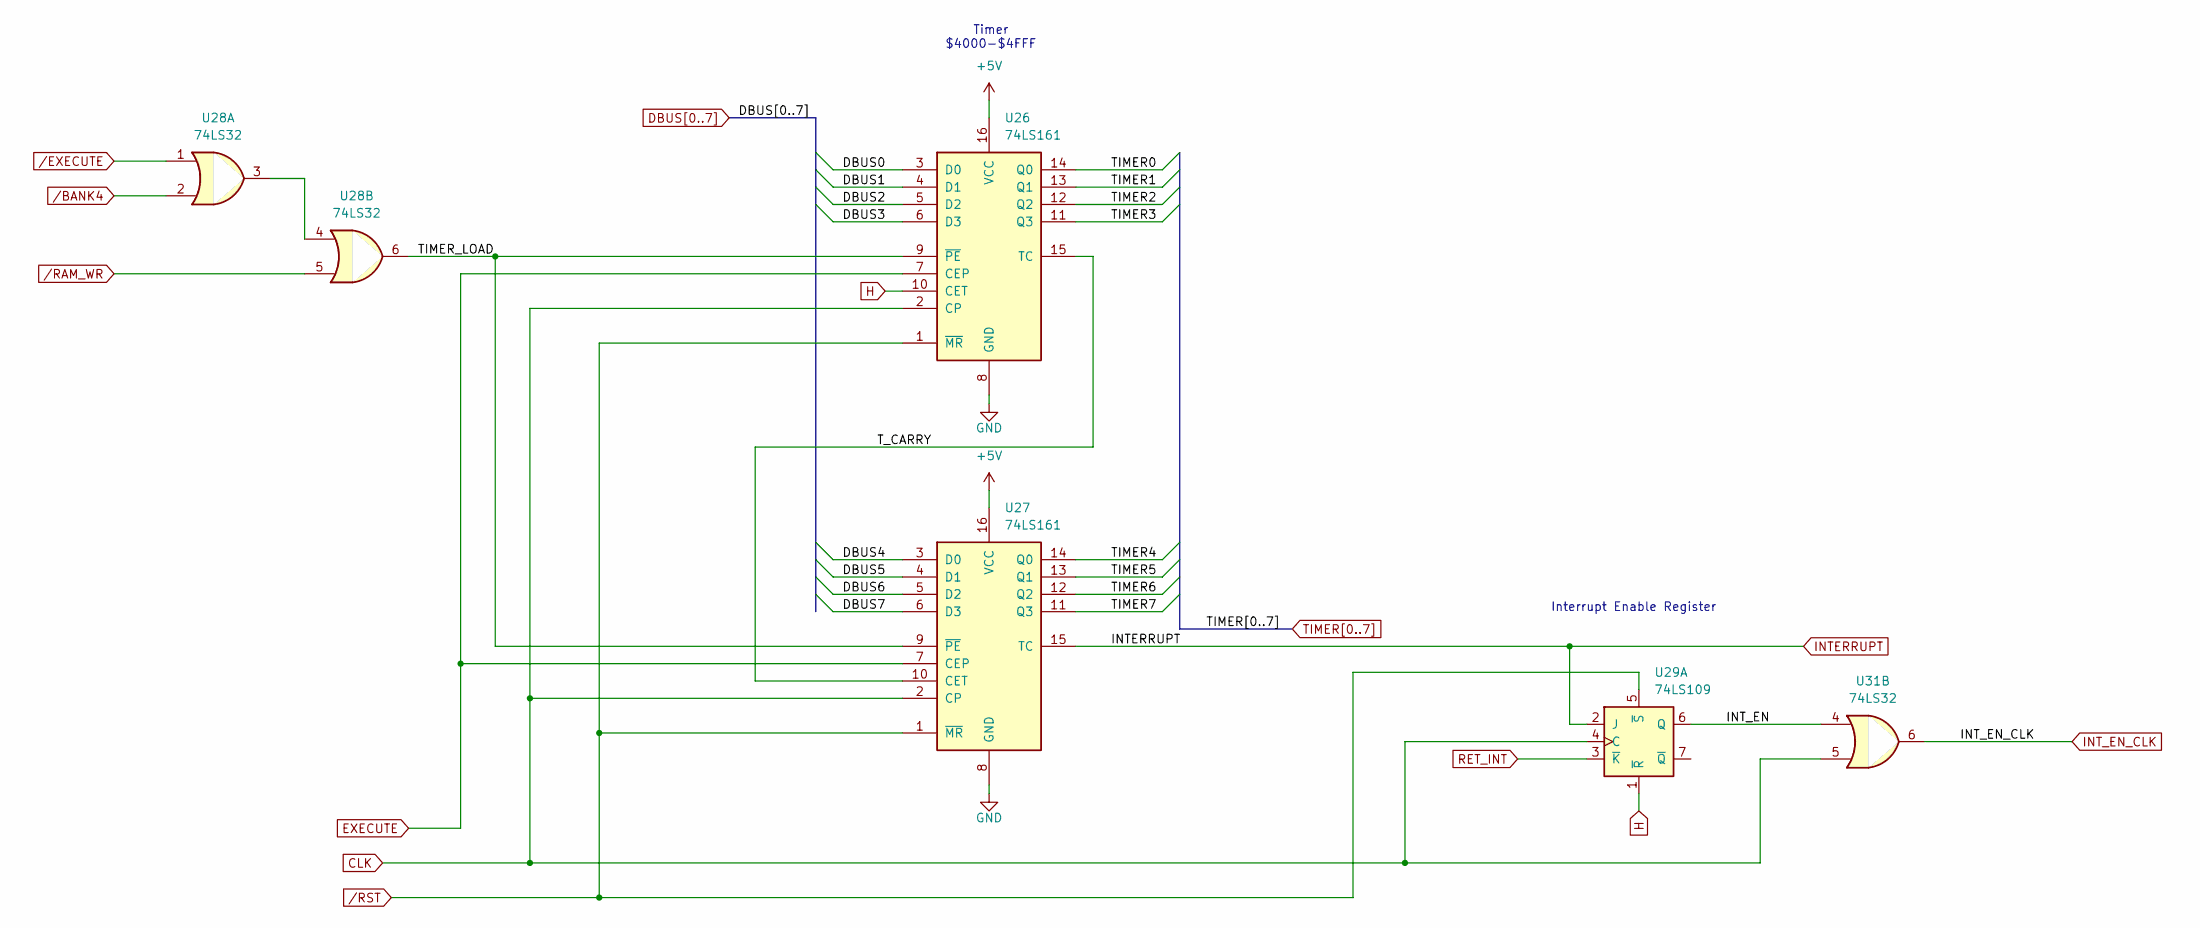
[picture p8: schematic TIMER.kicad_sch]

Parts:
U26, U27: 74LS161
U28, U31: 74LS32
U29: 74LS109

Connections:
+5V: U26.16 (VCC), U27.16 (VCC)
CLK: U26.2 (CP), U27.2 (CP), U29.4 (C), U31.5
DBUS0: U26.3 (D0)
DBUS1: U26.4 (D1)
DBUS2: U26.5 (D2)
DBUS3: U26.6 (D3)
DBUS4: U27.3 (D0)
DBUS5: U27.4 (D1)
DBUS6: U27.5 (D2)
DBUS7: U27.6 (D3)
EXECUTE: U26.7 (CEP), U27.7 (CEP)
GND: U26.8 (GND), U27.8 (GND)
H: U26.10 (CET), U29.1 (~R)
INTERRUPT: U27.15 (TC), U29.2 (J)
INT_EN: U29.6 (Q), U31.4
INT_EN_CLK: U31.6
unnamed: U28.3, U28.4
RET_INT: U29.3 (~K)
TIMER0: U26.14 (Q0)
TIMER1: U26.13 (Q1)
TIMER2: U26.12 (Q2)
TIMER3: U26.11 (Q3)
TIMER4: U27.14 (Q0)
TIMER5: U27.13 (Q1)
TIMER6: U27.12 (Q2)
TIMER7: U27.11 (Q3)
TIMER_LOAD: U26.9 (~PE), U27.9 (~PE), U28.6
T_CARRY: U26.15 (TC), U27.10 (CET)
/BANK4: U28.2
/EXECUTE: U28.1
/RAM_WR: U28.5
/RST: U26.1 (~MR), U27.1 (~MR), U29.5 (~S)

Notes on the sheet:
Timer $4000-$4FFF
Interrupt Enable Register
