tocksin/gtxl/src/hdl/rom_synth.vhd

/*
-- @file rom_synth.vhd
-- @brief ROM containing instructions
-- @author Justin Davis
--
    Copyright (C) 2024  Justin Davis

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
    You should have received a copy of the GNU Affero General Public License
    along with this program.  If not, see <https://www.gnu.org/licenses/>.
------------------------------------------------------------------------------*/
library ieee;           use ieee.std_logic_1164.all;
                        use ieee.numeric_std.all;

library work;           use work.tools_pkg.all;
                        use work.sys_description_pkg.all;

entity rom_synth is 
    port (  iAddr   : in    slv;
            oData   :   out slv(7 downto 0));
end entity rom_synth;

architecture rtl of rom_synth is
    type rom_type is array (0 to (2**iAddr'length)-1) of std_logic_vector(oData'range);
    signal rom : rom_type := ( 
    
 0 =>x"C2",
 1 =>x"00",
 2 =>x"0B",
 3 =>x"00",
 4 =>x"C2",
 5 =>x"01",
 6 =>x"01",
 7 =>x"03",
 8 =>x"60",
 9 =>x"37",
 10 =>x"EC",
 11 =>x"C6",
 12 =>x"FD",
 13 =>x"06",
 14 =>x"10",
 15 =>x"A2",
 16 =>x"18",
 17 =>x"00",
 18 =>x"01",
 19 =>x"08",
 20 =>x"60",
 21 =>x"18",
 22 =>x"F0",
 23 =>x"1A",
 24 =>x"01",
 25 =>x"08",
 26 =>x"80",
 27 =>x"01",
 28 =>x"02",
 29 =>x"00",
 30 =>x"18",
 31 =>x"40",
 32 =>x"C2",
 33 =>x"08",
 34 =>x"60",
 35 =>x"0B",
 36 =>x"F0",
 37 =>x"36",
 38 =>x"01",
 39 =>x"08",
 40 =>x"60",
 41 =>x"06",
 42 =>x"F0",
 43 =>x"40",
 44 =>x"00",
 45 =>x"0E",
 46 =>x"C2",
 47 =>x"06",
 48 =>x"01",
 49 =>x"00",
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
    16377 =>x"F9", --3FF9
    16378 =>x"FA", --3FFA
    16379 =>x"FB", --3FFB
    16380 =>x"FC", --3FFC
    16381 =>x"FD", --3FFD
    16382 =>x"FE", --3FFE
    16383 =>x"FF", --3FFF


    others => (others=>'0')
    );

begin
       oData <= rom(to_integer(unsigned(iAddr)));
end rtl;
