tocksin/gtxl/src/hdl/font_atasciii.vhd

-- @file rom_font.vhd
-- @brief ROM containing character font
-- @author Justin Davis
--
-- $Revision: -
-- $Date: 06/22/2023
-- $LastEditedBy: Justin Davis
--
-- Developed by 2023 Southwest Research Institute
-------------------------------------------------------------------------------
-- Font data taken from: https://github.com/robhagemans/hoard-of-bitfonts/blob/master/atari/8-bit/atascii.yaff

library ieee;           use ieee.std_logic_1164.all;
                        use ieee.numeric_std.all;

library work;           use work.tools_pkg.all;
                        use work.sys_description_pkg.all;

entity rom_font is
    port ( addrIn   : in    slv(10 downto 0) ;
           dataOut  :   out slv(7 downto 0));
end entity rom_font;

architecture rtl of rom_font is
   
    type rom_type is array (0 to (2**addrIn'length)-1) of std_logic_vector(dataOut'range);

	-- ROM definition
    signal rom : rom_type := ( 

-- # [?] BLACK HEART SUIT
-- u+2665:
-- 0x00:
    "00000000",
    "00110110",
    "01111111",
    "01111111",
    "00111110",
    "00011100",
    "00001000",
    "00000000",


-- # [?] BOX DRAWINGS LIGHT VERTICAL AND RIGHT
-- u+251c:
-- 0x01:
    "00011000",
    "00011000",
    "00011000",
    "00011111",
    "00011111",
    "00011000",
    "00011000",
    "00011000",


-- # [?] RIGHT VERTICAL BOX LINE
-- u+23b9:
-- 0x02:
    "00000011",
    "00000011",
    "00000011",
    "00000011",
    "00000011",
    "00000011",
    "00000011",
    "00000011",


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
    "11000111",
    "11100111",
    "11110111",
    "11111111",

-- 0xff:
    "11101111",
    "11100111",
    "11100011",
    "11100001",
    "11100011",
    "11100111",
    "11101111",
    "11111111"

	);
begin

    dataOut <= ROM(to_integer(unsigned(addrIn)));
	
end architecture rtl;
