tocksin/gtxl/src/hdl/font_pet.vhd

-- @file rom_font.vhd
-- @brief ROM containing character font
-- @author Justin Davis
--
-- $Revision: -
-- $Date: 06/22/2023
-- $LastEditedBy: Justin Davis
--
-- Developed by 2023 Southwest Research Institute
-------------------------------------------------------------------------------
-- Font data taken from: https://github.com/robhagemans/hoard-of-bitfonts/blob/master/commodore/pet/pet.yaff

library ieee;           use ieee.std_logic_1164.all;
                        use ieee.numeric_std.all;

library work;           use work.tools_pkg.all;
                        use work.sys_description_pkg.all;

entity rom_font is
    port ( addrIn   : in    slv(10 downto 0) ;
           dataOut  :   out slv(7 downto 0));
end entity rom_font;

architecture rtl of rom_font is
   
    type rom_type is array (0 to (2**addrIn'length)-1) of std_logic_vector(dataOut'range);

    -- ROM definition
    signal rom : rom_type := ( 

-- # [1] COMMERCIAL AT
-- 0x00:
-- u+0040:
    "00011100",
    "00100010",
    "01001010",
    "01010110",
    "01001100",
    "00100000",
    "00011110",
    "00000000",


-- # [A] LATIN CAPITAL LETTER A
-- 0x01:
-- u+0041:
    "00011000",
    "00100100",
    "01000010",
    "01111110",
    "01000010",
    "01000010",
    "01000010",
    "00000000",


-- # [B] LATIN CAPITAL LETTER B
-- 0x02:
-- u+0042:
    "01111100",
    "00100010",
    "00100010",
    "00111100",
    "00100010",
    "00100010",
    "01111100",
    "00000000",


-- # [C] LATIN CAPITAL LETTER C
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
    "00000000",
    "00000000",
    "00000000",
    "11110000",
    "11110000",
    "11110000",
    "11110000",


-- # [▝] QUADRANT UPPER RIGHT
-- 0xfc:
-- u+259d:
    "00001111",
    "00001111",
    "00001111",
    "00001111",
    "00000000",
    "00000000",
    "00000000",
    "00000000",


-- # [┘] BOX DRAWINGS LIGHT UP AND LEFT
-- 0xfd:
-- u+2518:
    "00001000",
    "00001000",
    "00001000",
    "00001000",
    "11111000",
    "00000000",
    "00000000",
    "00000000",


-- # [▘] QUADRANT UPPER LEFT
-- 0xfe:
-- u+2598:
    "11110000",
    "11110000",
    "11110000",
    "11110000",
    "00000000",
    "00000000",
    "00000000",
    "00000000",


-- # [▚] QUADRANT UPPER LEFT AND LOWER RIGHT
-- 0xff:
-- u+259a:
    "11110000",
    "11110000",
    "11110000",
    "11110000",
    "00001111",
    "00001111",
    "00001111",
    "00001111",

    );
begin

    dataOut <= ROM(to_integer(unsigned(addrIn)));

end architecture rtl;
