tocksin/gtxl/(commit log)

2024-12-20 initial checkin
    [Assembly.xlsx]
2024-12-20 Change interrupt polarity to eliminate gates
2024-12-23 Replace timer buffer with chip
    [cpu.vhd]
2024-12-27 switch interrupt to J/K FF to remove logic gates. swap data bus access modes (mem/AC) to match gigatron
    [control.vhd, cpu.vhd, rom_synth.vhd, sn74hct109.vhd]
2024-12-30 Add PCB files
    [ALU.kicad_sch, MAU.kicad_sch, MEM.kicad_sch, PC.kicad_sch, REGS.kicad_sch, STATE.kicad_sch, TIMER.kicad_sch, gtxl.kicad_pcb]
2024-12-30 Add keyboard and audio blocks
    [Assembly.xlsx]
2025-01-03 Add immediate value memory access mode. Make all address modes the same as original gigatron. Change assembly worksheet to match and update test code.
    [Assembly.xlsx]
2025-01-08 Remove timer registers. Change X register to be the new timer.
    [Assembly.xlsx]
2025-01-08 Remove interrupt enable register. Change lower MAU byte to tristates instead of MUXes.
2025-01-08 remove xBus. Change assembly to conform with the new architecture.
    [Assembly.xlsx]
2025-01-10 Add assembler ruleset for instruction set
    [Assembly.xlsx]
2025-01-13 Update schematic with removed timer. Update video timing notes.
    [KEEB.kicad_sch, MAU.kicad_sch, MEM.kicad_sch, PC.kicad_sch, REGS.kicad_sch, STATE.kicad_sch, TIMER.kicad_sch, gtxl.kicad_sch]
2025-01-15 Update instruction set to reflect tri-stating Y bus. Add default to immediate mode access during branches.
    [Assembly.xlsx]
2025-01-17 Add assembly for video timing. Add Y bus enabled for jumps. Fix lower memory address muxing problem (still not completely solved, but is working - I think some issue with tri-stating).
    [Assembly.xlsx]
2025-01-20 improve timing to meet rs-170 standard.
    [Assembly.xlsx]
2025-01-21 Complete interrupt timing routines for first frame of video
