tocksin/gtxl/(notices)

Notices in the files:
src/hdl/control.vhd:
This program is free software: you can redistribute it and/or modify
it under the terms of the GNU Affero General Public License as published
